cnYui/switch-robot-diy/demo/animation_contact_sheet.jpg

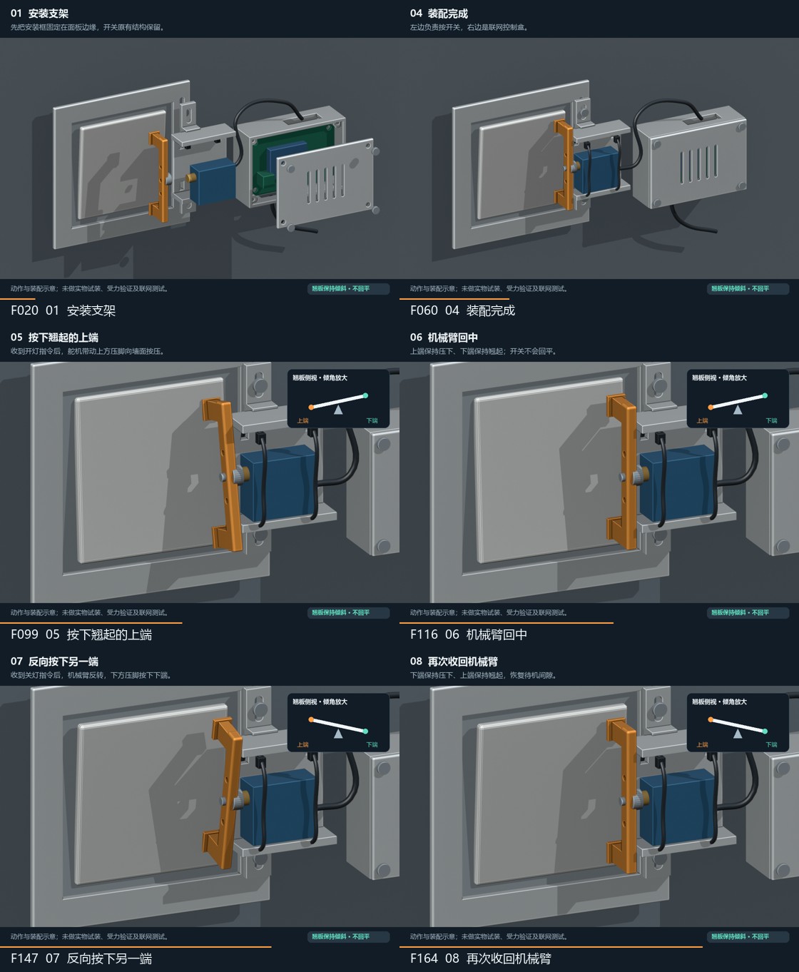
demo/animation_contact_sheet.jpg
