cnYui/switch-robot-diy/electronics/v04/carrier_v04_pcb.png

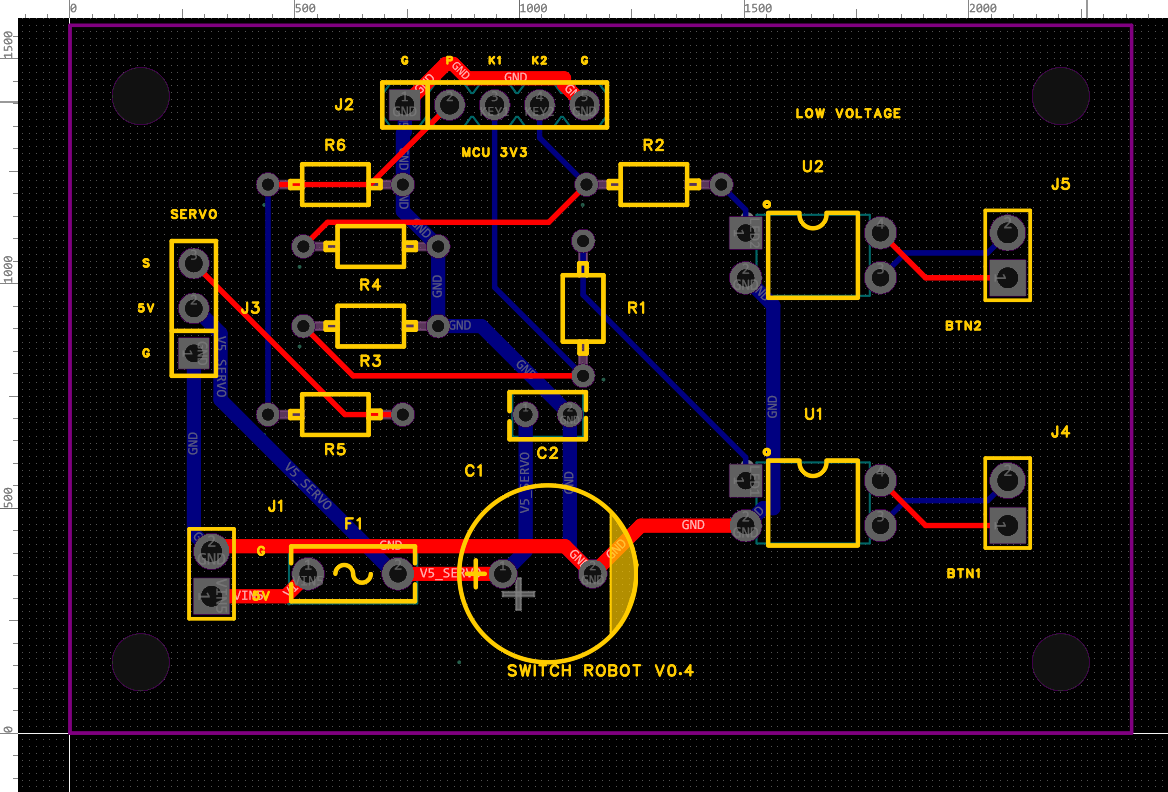
electronics/v04/carrier_v04_pcb.png
