cnYui/switch-robot-diy/fit-check/case_v03_pcb_fit.png

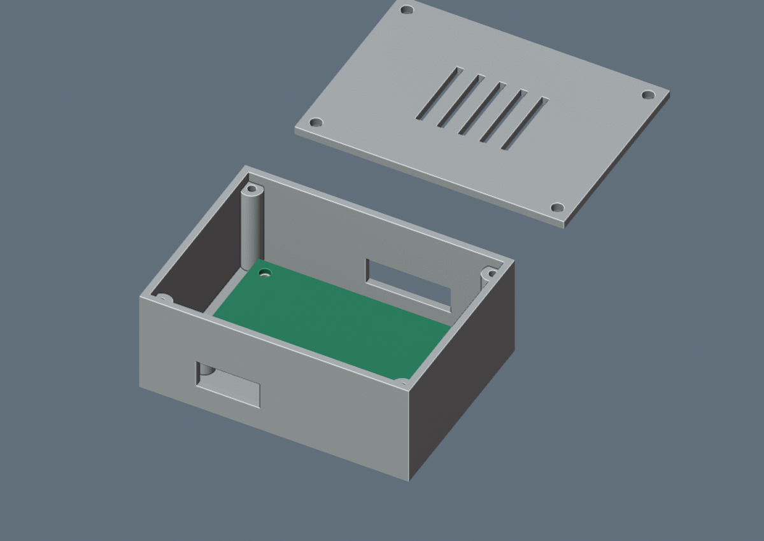
fit-check/case_v03_pcb_fit.png
