cnYui/switch-robot-diy/fit-check/pcb_case_fit_audit.png

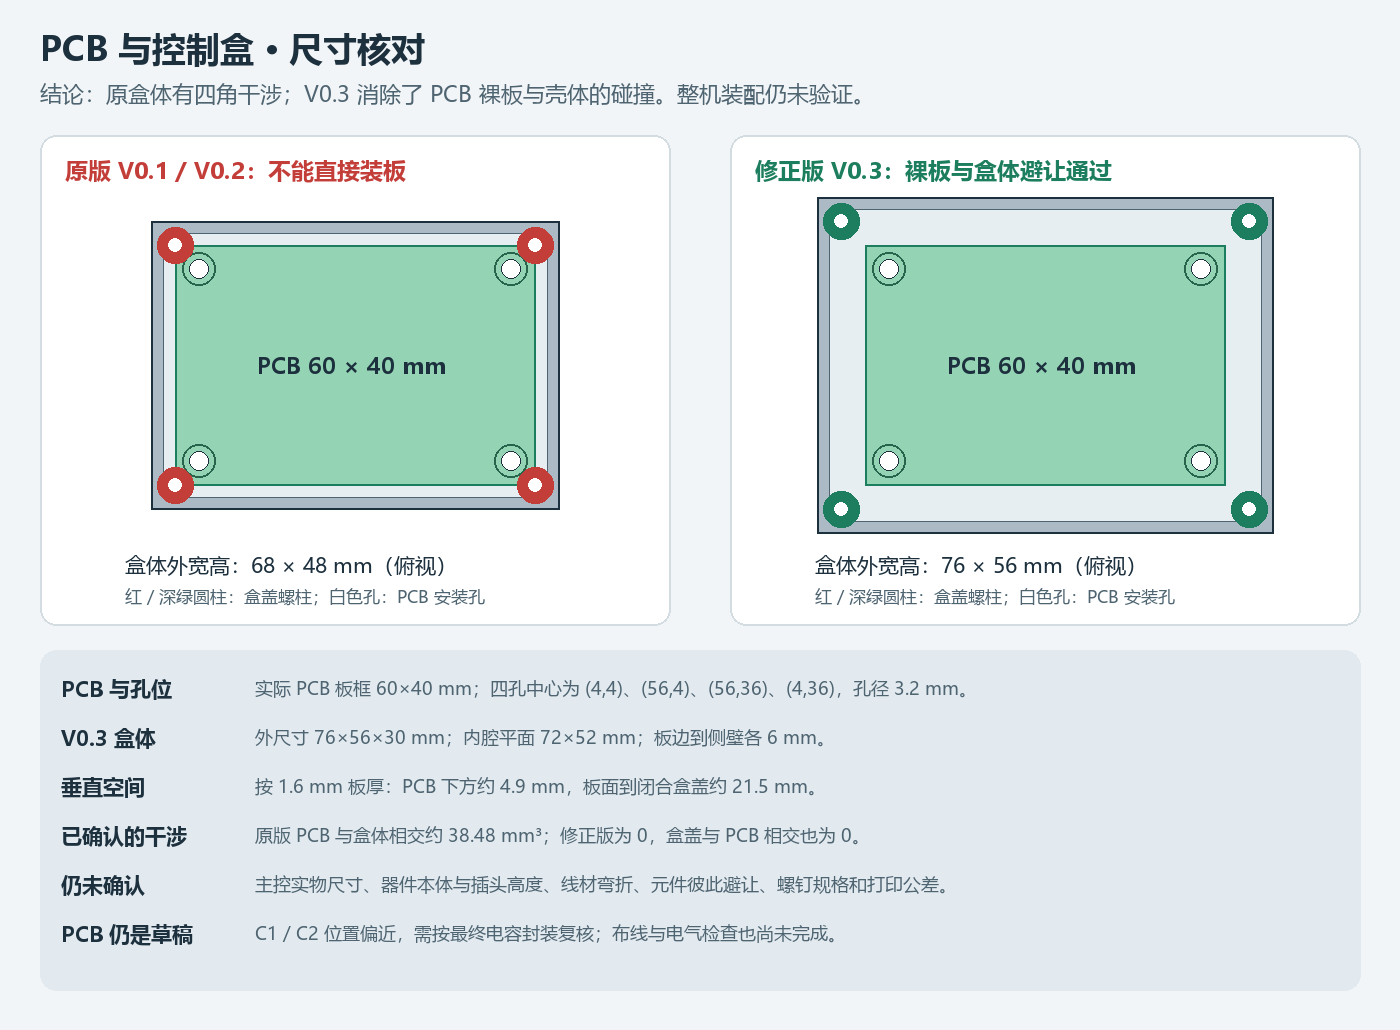
fit-check/pcb_case_fit_audit.png
