cnYui/switch-robot-diy/mechanical/HARDWARE_BOM.md

# 五金与小件采购清单（V0.7 紧固件，2026-11-12）

## V0.7 紧固件（已在 CAD 里建实体并做干涉检查）

每颗螺丝和垫圈都在 switch_robot_86_v07_fasteners.blend 里有实体（名字以 FASTENER_ 开头，自定义属性里写了规格和淘宝规格名）。M3 盘头：头径 5.3、头厚 1.9、螺纹 3.0 mm，取自卖家规格图；M2 头部尺寸是假设值。build_fasteners.py 建模，verify_fasteners.py 用取点法算干涉和咬合，结果在 fastener_checks_v07.json。

| 编号 | 位置 | 规格 | 用量 | 拧进深度（计算） | 尖端后余量 | 干涉 |
|---|---|---|---|---|---|---|
| F1 | PCB → 盒底螺柱 | 盘头十字自攻 M3×6（PA3×6）304 | 4 | 3.5 mm（螺柱 Ø2.3 预钻孔） | 1.5 mm | 无 |
| F2 | 盒盖 → 盖柱 | M3×12 | 4 | 5.7 mm | 孔还剩约 20 mm | 无 |
| F3 | 舵机支架脚 → 框 | M3×6 | 2 | **1.5 mm，偏弱** | 1.05 mm 到 86 面板 | 无 |
| W1 | 支架脚下垫高 | 平垫圈 3.2×7×0.5 | 2（每脚 1 片） | — | — | 无 |
| F4 | 按压臂 → SG90 舵盘 | M2×6 | 2 | 舵盘没建模，未算 | — | 无 |
| — | 舵盘中心螺丝 | SG90 随附 | 1 | — | — | — |

相对 V0.6 改了两处：

1. 网关盒换成 V0.3（76×56×30）。旧的 68×48×22 盒四根盖柱落在 PCB 四个角，装不下（fit-check 早就查出，但 mechanical 里一直是旧盒）。旧 STL 移到 archive，文件名里写了 DOES_NOT_FIT。
2. 垫高 1.0 mm 改为：框下贴 0.5 mm 亚克力泡棉双面胶 + 每个支架脚下 1 片 0.5 mm 垫圈。舵机和按压臂相对翘板的高度与仿真一致。

F3 只咬进框 1.5 mm：框只有 3 mm 厚，换 M3×8 尖端会顶到 86 面板。支架受力只有几牛，先这样装；拧完晃一下，松就在孔里点一滴 502 再拧。

淘宝规格（商品页上看到的规格名和价格，未含运费）：

| 件 | 店 | 规格名 | 价格 |
|---|---|---|---|
| F1 / F3 | [佰瑞特官方旗舰店](https://detail.tmall.com/item.htm?id=15858629599) | M3\*6（200粒)304 | ¥4.86 |
| F2 | 同上 | M3\*12（200粒)304 | ¥6.64 |
| F4 | 同上 | M2\*6（200粒)304 | ¥3.56 |
| W1 | [天卓五金官方旗舰店](https://detail.tmall.com/item.htm?id=849674040028) | 3\*7\*0.5(500只) | ¥14.04 |

合计 ¥29.10。

## V0.6 原始推导（留作对照，螺丝以上面 V0.7 为准）

## 螺丝与垫片

| 位置 | CAD 依据 | 规格 | 用量 | 建议买 |
|---|---|---|---|---|
| PCB → 盒底螺柱（4 处） | PCB 孔 Ø3.2；螺柱预钻孔 Ø2.3、深约 5.9 mm；PCB 厚 1.6 mm | M3×6 圆头（盘头）十字 自攻螺丝（PA 型，尖头） | 4 | 20 |
| 盒盖 → 盒盖螺柱（4 处） | 盒盖孔 Ø3.3、盖厚 2.4 mm；螺柱顶面比盒口低 3 mm；预钻孔 Ø2.3 | M3×12 圆头十字 自攻螺丝（PA 型） | 4 | 20 |
| 支架 → 框（2 处） | 框改为 Ø2.5 预钻孔（见下）；叠层：支架脚 3 mm + 垫圈 1.0 mm + 框 3 mm | M3×6 圆头十字 自攻螺丝（PA 型），拧进框里约 2 mm | 2 | 20（与上面同规格，合并买） |
| 支架脚下垫高（名义 1.0 mm） | 每个脚两片 0.5 mm | M3 平垫圈，厚 0.5 mm（DIN125，内径 3.2、外径 7）；不锈钢 | 4 | 20；另买一包 M3 超薄垫片（0.1 / 0.2 / 0.3 / 0.5 / 1.0 mm）用来微调高度 |
| 舵盘 → 按压臂 | 臂上孔：中心 Ø2.5，两侧 Ø2.2，间距 ±9 mm，臂厚 4 mm | 用 SG90 随附的中心螺丝和 2 颗小自攻螺丝；备用 M2×6 圆头自攻螺丝 | 3 | 买舵机时确认带配件包；备用 M2×6 买 10 |
| 舵机固定 | 支架上的绑带孔 3.2×6 mm（共 4 个，两道绑带） | 尼龙扎带 2.5 mm 宽 × 100 mm 长（3 mm 宽的穿不过） | 2 | 100 |

买自攻螺丝时认 “PA 型 / 自攻螺丝 / 圆头（盘头）/ 十字”，不要买机牙螺丝（M3 机牙需要攻丝）。材质 304 不锈钢或镀黑锌碳钢都行，塑料里拧自攻钉，碳钢更利。

## 其他要买的小件

| 件 | 规格 | 数量 | 说明 |
|---|---|---|---|
| 舵机 | SG90 9g，塑料齿，带配件包 | 1 + 1 备 | 设计参数按 SG90 假设；翻转阻力实测超过 4 N 就要换更大力矩的舵机 |
| 弹性压垫 | 5 mm 厚、带背胶的闭孔泡棉或硅胶海绵，裁成 4×7 mm | 2（裁片需要整张） | 仿真假设压缩刚度 2 N/mm，实测 1.5 ~ 2.5 才合适；建议买软硬两种各一小张，装机后比较 |
| 双面胶（框 → 86 面板） | 亚克力泡棉双面胶，0.5 mm 厚优先 | 1 卷 | 胶的厚度会抬高整个支架，等于垫圈的一部分：垫圈 + 胶 总共约 1.0 mm，别叠加 |
| 杜邦线 | 2.54 mm 母对母 20 cm | 1 包 | PCB 的 J1 ~ J5 都是 2.54 mm 排针 |
| 螺丝刀 | PH0 + PH1 十字 | 1 套 | PH0 拧 M2，PH1 拧 M3 |

## 这次为了能装上，改了一处 CAD

框（PRINT_01）原来在 (42, ±29) 有 3.4 mm 的通槽，钉头或螺母会落在下面的 86 面板上（面板边缘在 x = 43，槽在 x = 40.3 ~ 43.7），装不上。改成实心 + Ø2.5 mm 预钻孔，自攻螺丝从支架脚上方直接拧进框里。支架脚上的 3.4 mm 长孔保留，仍可沿 y 方向调 ±3 mm。新 STL 为 mechanical/PRINT_01_86_adjustable_frame.stl，旧的在 mechanical/archive。仿真没有重跑：框的碰撞体不含槽，碰撞模型不受影响。

## 未核实（收货后先量）

1. 螺柱预钻孔 Ø2.3 对 M3 自攻螺丝偏紧，先打一个样；拧不进或柱子开裂，就用 2.5 mm 钻头手扩。
2. 螺柱孔深、PCB 实际厚度：PCB 按 1.6 mm 假设。
3. 舵盘的孔位和厚度：臂上的孔距 ±9 mm 是按 SG90 双臂舵盘假设的，拿到实物先对。
4. 支架脚与框之间叠层超过 1.5 mm 时（垫圈 + 胶），M3×6 在框里不到 1.5 mm，咬合偏少；此时改用 M3×8 并让钉尖落在框的外沿，或把垫高改回用更薄的胶。
5. 压垫刚度；SG90 的力矩与翻转阻力。

## 淘宝商品（2026-11-12 搜索结果）

通过本机的 cn-scraper-mcp 搜索得到。价格是列表上的默认规格价，实际价格以你在页面里选的规格为准；销量是列表显示的“N 人付款”。规格选项（长度、数量、材质）要进商品页自己选，我没法替你确认，下面写了该选什么。没有加购物车，也没有下单。

| 件 | 选的商品 | 列表价 | 销量 | 进页面后选什么 / 注意 |
|---|---|---|---|---|
| M3×6 和 M3×12 自攻螺丝（同一个商品） | [304 不锈钢圆头自攻螺丝 佰瑞特](https://item.taobao.com/item.htm?id=15858629599) | M3×6 200 粒 ¥2.13；M3×12 200 粒 ¥3.64 | 3 万+ | 两个长度各拍一份。备选：[M3×6 100 只](https://item.taobao.com/item.htm?id=556999745246) ¥2.65，[M3×12 100 只](https://item.taobao.com/item.htm?id=15639979370) ¥3.66 |
| M3 垫圈 0.5 mm（垫高用） | [天卓五金 304 平垫片 3×5×0.5 500 只](https://item.taobao.com/item.htm?id=849674040028) | ¥7.71 | 2000+ | 外径 5 mm，收到后确认 M3 螺丝能穿过；穿不过就改买 [M3×6×0.5 的 2000 个装](https://item.taobao.com/item.htm?id=721571255302) ¥16.70（全网 70 万+） |
| 微调用 0.2 mm 垫圈 | [304 平垫圈 M3×5×0.2 200 粒](https://item.taobao.com/item.htm?id=941703196459) | ¥2.22 | 1 万+ | 与 0.5 mm 配合可以做 0.2 / 0.5 / 0.7 / 1.0 的组合 |
| M2×6 自攻螺丝（舵盘备用） | [9g 舵机自攻螺丝 M2×6 100 颗](https://item.taobao.com/item.htm?id=543737994601)（牛牌航空工厂店） | ¥4.49 | 100+ | 选 M2×6 |
| 扎带 2.5 mm 宽 × 100 mm | [自锁式尼龙扎带 PA66 100 条](https://item.taobao.com/item.htm?id=765121326094) | ¥2.12 | 4 万+ | 选宽 2.5 mm、长 100 mm 的规格。备选：[2.5×100 mm 100 根](https://item.taobao.com/item.htm?id=976187157563) ¥3.22 |
| SG90 舵机 | [SG90 9G 舵机 带配件](https://item.taobao.com/item.htm?id=678498890304) | ¥5.67 | 3 万+ | 买 2 个。列表里有“5 孔 / 6 孔”等舵盘版本，对照臂上的孔距 ±9 mm 选，拿不准就问客服要双臂舵盘的孔距；备用舵盘包：[5 孔配件包](https://item.taobao.com/item.htm?id=744224321565) ¥0.99 |
| 更大力矩的备选舵机 | [SG90 / MG90S](https://item.taobao.com/item.htm?id=580422934211)（新动模型） | ¥5.15 | 1000+ | 选 MG90S（金属齿），买 1 个备用；实测开关阻力超过 4 N 才用得上 |
| 压垫 A：泡棉 | [3M 海绵胶带 5 mm 厚 1 cm×2 m](https://item.taobao.com/item.htm?id=656224946508) | ¥6.87 | 1 万+ | 裁成 4×7 mm |
| 压垫 B：硅胶发泡 | [祥晨自粘硅胶发泡板 200×300×5 mm](https://item.taobao.com/item.htm?id=660657977751) | ¥7.90 | 10 万+ | 如果有软硬度选项，各选一种；与泡棉对比装机后的手感和仿真假设的 2 N/mm |
| 框与面板的双面胶 | [亚克力泡棉双面胶 0.5 mm 厚 10 mm 宽 × 33 m](https://item.taobao.com/item.htm?id=941026615259)（加腾胶带） | ¥12.54 | 26 | 销量很少。备选：[1 mm 厚 5 mm 宽 30 m 的亚克力双面胶](https://item.taobao.com/item.htm?id=878944546787) ¥3.36（1 万+），用 1 mm 的胶就不用再垫垫圈 |
| 杜邦线 | [全铜杜邦线 母对母 20 cm 40P](https://item.taobao.com/item.htm?id=843896292070) | ¥7.60 | 1000+ | |
| 十字螺丝刀 | [得力精密螺丝刀套装 57 件](https://item.taobao.com/item.htm?id=726463206932) | ¥56.90 | 900+ | 确认套装里有 PH0 和 PH1；只想花 10 多块可以看 [S2 磁性 12 件套](https://item.taobao.com/item.htm?id=608364940838) ¥12.70，同样要确认有 PH0 / PH1 |

这份清单没验证：各规格是否有货、长度和数量的实际 SKU、泡棉和硅胶的软硬度、舵盘孔距。商品详情接口不稳定，12 个里只拿到 3 个，所以没有逐项核对页面。
