cnYui/switch-robot-diy/electronics/v04/carrier_v04_bom.csv

No. | Quantity | Comment | Designator | Footprint | Value | Manufacturer Part | Manufacturer | Supplier Part | Supplier
1 | 1 | 470uF | C1 | CAP-TH_BD10.0-P5.00-D1.0-FD | 470uF | EEUFR1E471 | PANASONIC(松下) | C407944 | LCSC
2 | 1 | 100nF | C2 | CAP-TH_L4.0-W2.5-P2.50-D0.5 | 100nF | FK18X7R1H104K | TDK | C3689569 | LCSC
3 | 1 | RUEF110 | F1 | FUSE-TH_L7.0-W3.1-P5.08-D1.2 |  | RUEF110 | Littelfuse(美国力特) | C5395 | LCSC
4 | 3 | PZ254V-11-02P | J1,J4,J5 | HDR-TH_2P-P2.54-V-M |  | PZ254V-11-02P | XFCN(兴飞) | C492401 | LCSC
5 | 1 | PZ254V-11-05P | J2 | HDR-TH_5P-P2.54-V-M |  | PZ254V-11-05P | XFCN(兴飞) | C492404 | LCSC
6 | 1 | PZ254V-11-03P | J3 | HDR-TH_3P-P2.54-V-M_PZ254V-11-03P |  | PZ254V-11-03P | XFCN(兴飞) | C2937625 | LCSC
7 | 2 | 470Ω | R1,R2 | RES-TH_BD2.3-L3.7-P7.70-D0.9 | 470Ω | MF1/8W-470Ω±1%-OT52 | VO(翔胜) | C2848568 | LCSC
8 | 3 | 100kΩ | R3,R4,R6 | RES-TH_BD2.3-L3.7-P7.70-D0.9 | 100kΩ | MF1/8W-100K±1%-OT26 | VO(翔胜) | C2903382 | LCSC
9 | 1 | 220Ω | R5 | RES-TH_BD2.3-L3.7-P7.70-D0.9 | 220Ω | MF1/8W-220Ω±1%-OT52 | VO(翔胜) | C2848564 | LCSC
10 | 2 | AQY212EH | U1,U2 | DIP-4_L6.4-W4.8-P2.54-LS7.6-BL |  | AQY212EH | PANASONIC(松下) | C2894775 | LCSC
