cnYui/switch-robot-diy/electronics/v04/3d/carrier_v04_populated.obj

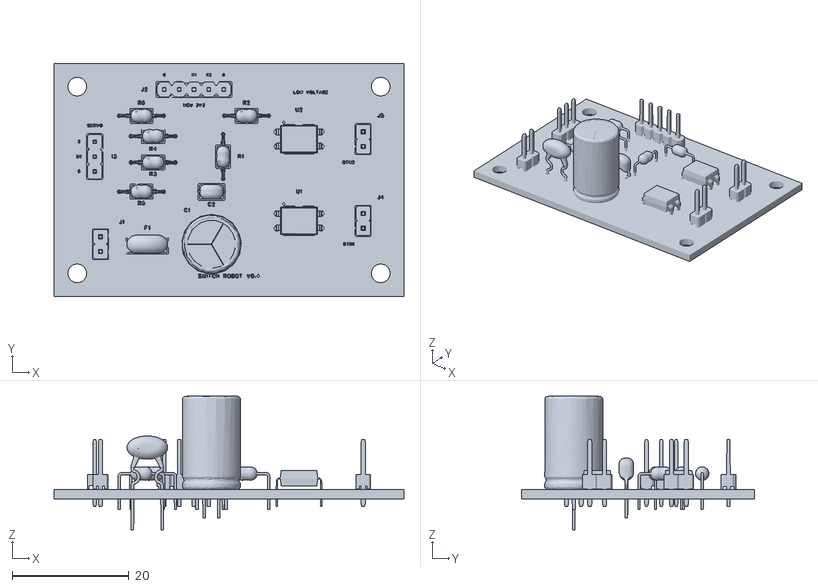
[picture p5: CAD file, 2026-11-12]
electronics/v04/3d/carrier_v04_populated.obj
60.0 x 40.0 x 22.9
