cnYui/switch-robot-diy/fit-check/V03_PRINT_gateway_lid_76x56.stl

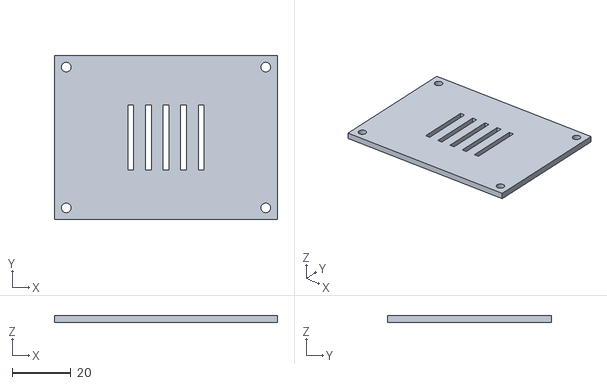
[picture p6: CAD file, 2026-11-12]
fit-check/V03_PRINT_gateway_lid_76x56.stl
76.0 x 56.0 x 2.40
