cnYui/switch-robot-diy/mechanical/PRINT_02_strap_servo_cradle.stl

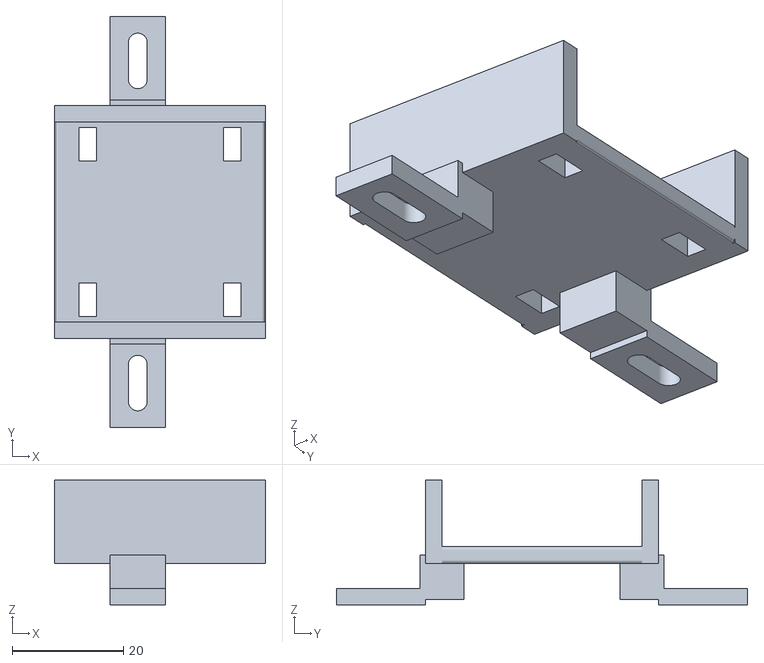
[picture p7: CAD file, 2026-11-12]
mechanical/PRINT_02_strap_servo_cradle.stl
38.0 x 74.0 x 22.5
