cnYui/switch-robot-diy/simulation/assets/pcb_material_00.obj

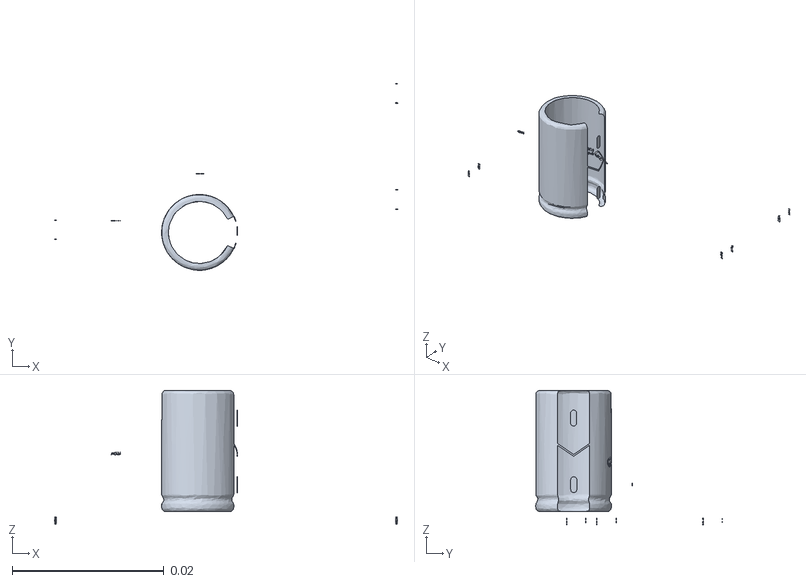
[picture p8: CAD file, 2026-11-12]
simulation/assets/pcb_material_00.obj
0.0453 x 0.0246 x 0.0177
