cnYui/switch-robot-diy/simulation/V05_CANDIDATE_press_arm.stl

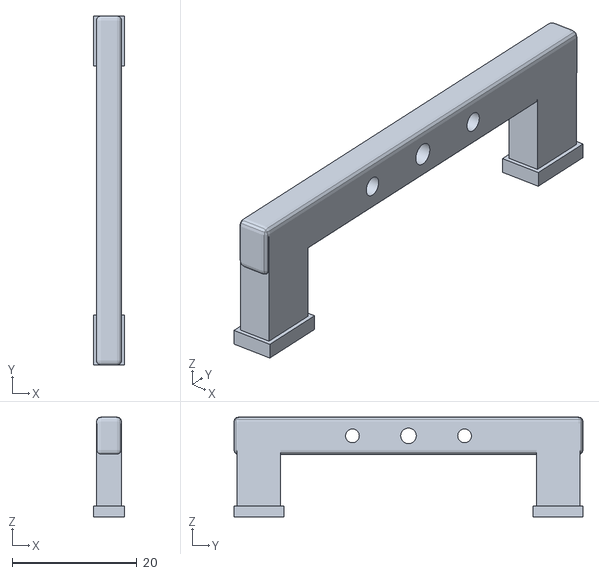
[picture p9: CAD file, 2026-11-12]
simulation/V05_CANDIDATE_press_arm.stl
5.00 x 56.0 x 16.0
