cnYui/switch-robot-diy/fit-check/V03_PRINT_gateway_case_76x56x30.stl

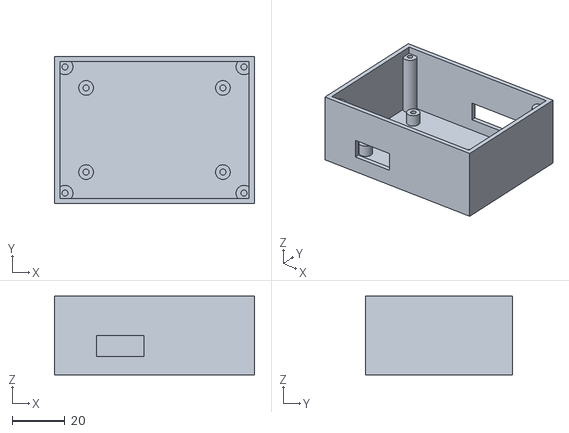
[picture p10: CAD file, 2026-11-12]
fit-check/V03_PRINT_gateway_case_76x56x30.stl
76.0 x 56.0 x 30.0
