cnYui/switch-robot-diy/simulation/assets/pcb_material_03.obj

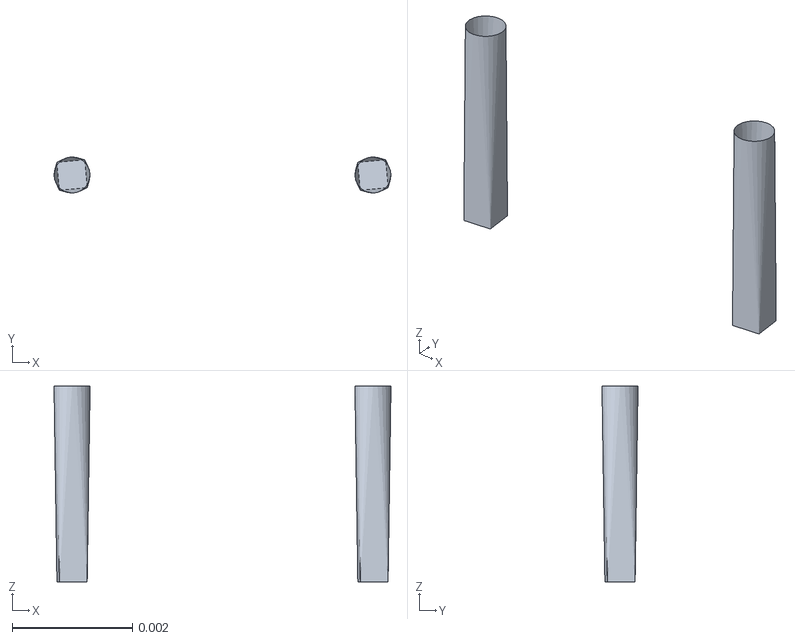
[picture p11: CAD file, 2026-11-12]
simulation/assets/pcb_material_03.obj
0.0056 x 0.0006 x 0.00325
