cnYui/switch-robot-diy/simulation/V06_press_arm.stl

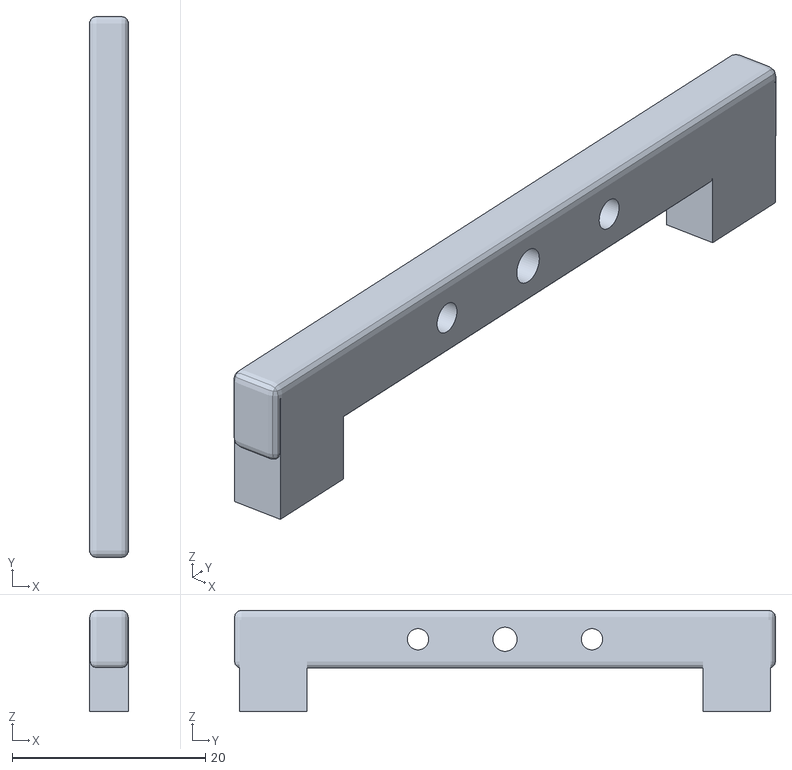
[picture p12: CAD file, 2026-11-12]
simulation/V06_press_arm.stl
4.00 x 56.0 x 10.5
