cnYui/switch-robot-diy/mechanical/PRINT_01_86_adjustable_frame.stl

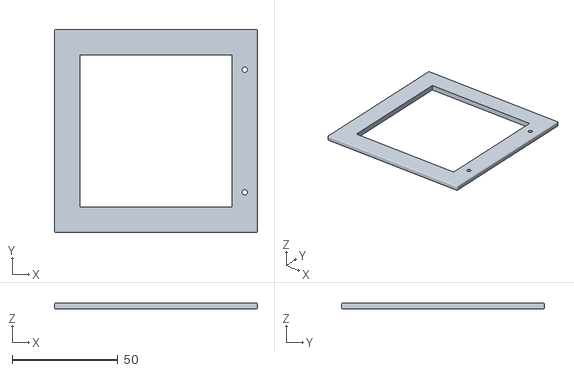
[picture p13: CAD file, 2026-11-12]
mechanical/PRINT_01_86_adjustable_frame.stl
96.0 x 96.0 x 3.00
