cnYui/switch-robot-diy/simulation/assets/frame_col_01.obj

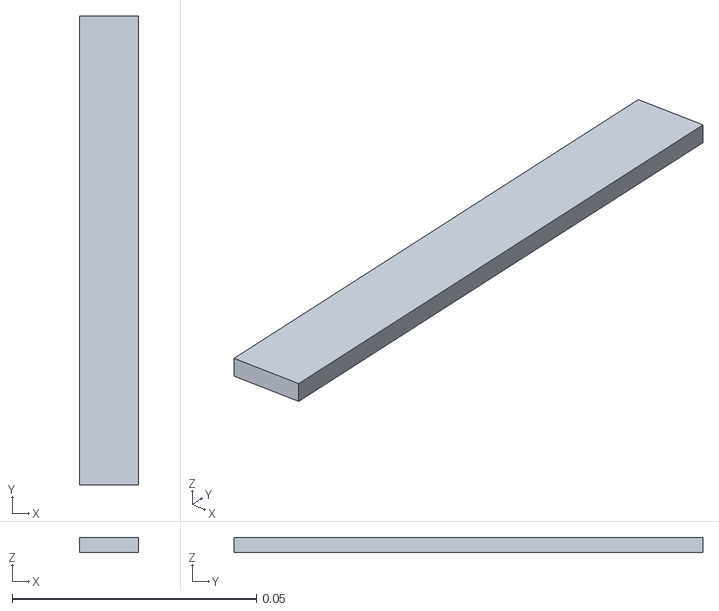
[picture p14: CAD file, 2026-11-12]
simulation/assets/frame_col_01.obj
0.012 x 0.096 x 0.003
