cnYui/switch-robot-diy/simulation/assets/cradle_col_04.obj

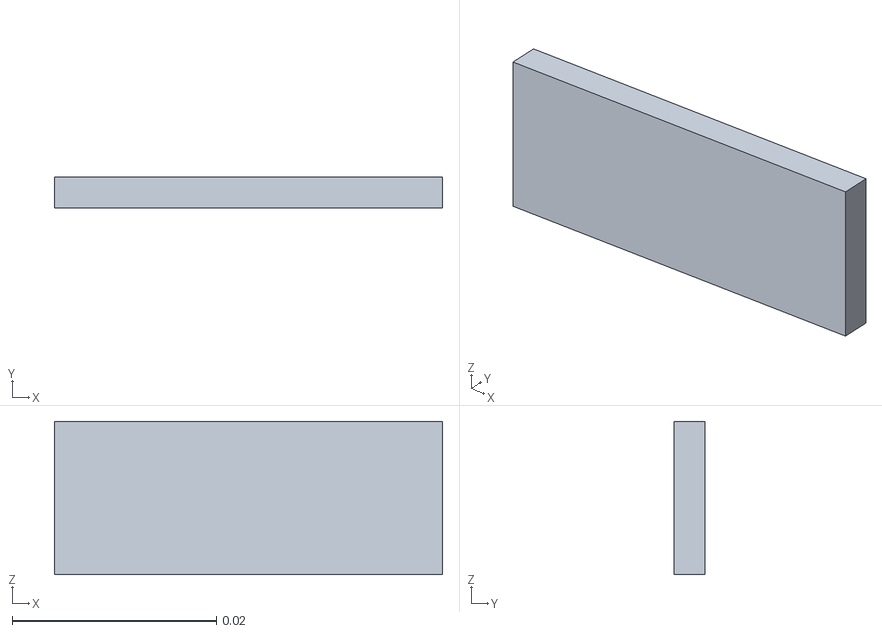
[picture p15: CAD file, 2026-11-12]
simulation/assets/cradle_col_04.obj
0.038 x 0.003 x 0.015
