cnYui/switch-robot-diy/simulation/assets/cradle_col_02.obj

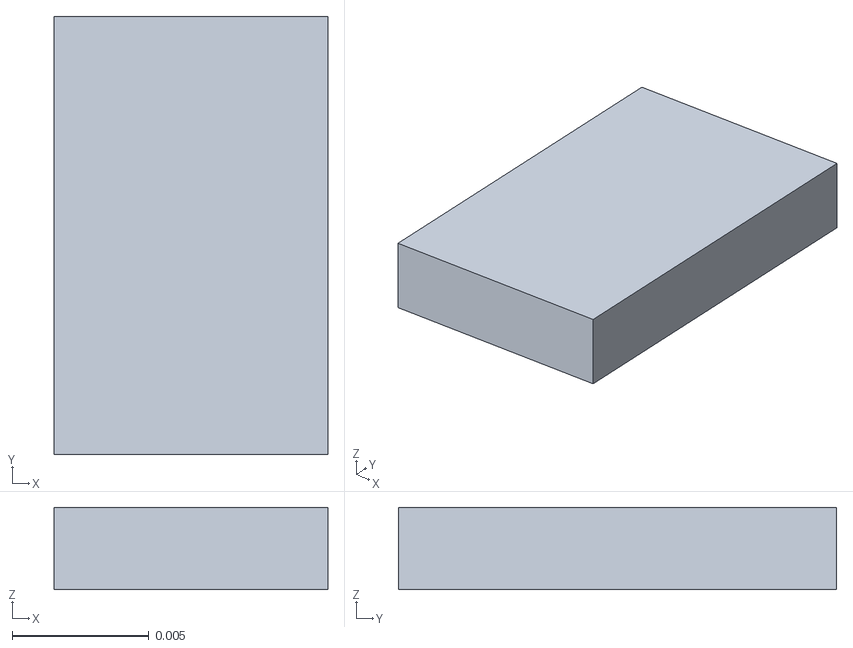
[picture p16: CAD file, 2026-11-12]
simulation/assets/cradle_col_02.obj
0.01 x 0.016 x 0.003
