cnYui/switch-robot-diy/simulation/assets/pcb_material_07.obj

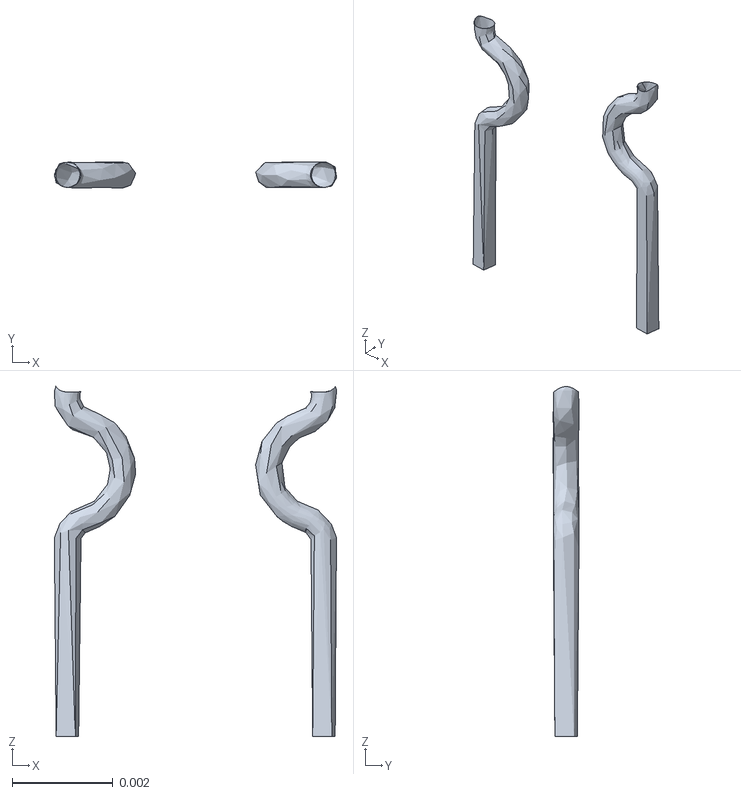
[picture p17: CAD file, 2026-11-12]
simulation/assets/pcb_material_07.obj
0.00561 x 0.000518 x 0.00696
