cnYui/switch-robot-diy/simulation/assets/pcb_material_15.obj

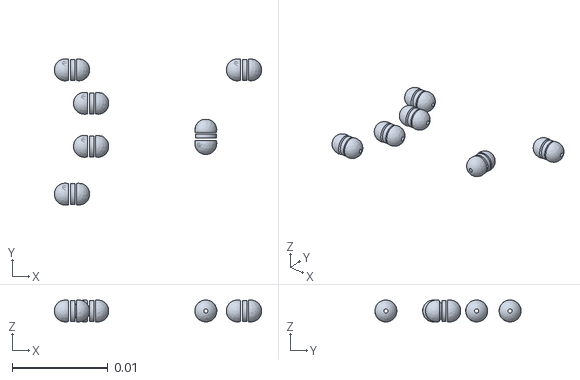
[picture p18: CAD file, 2026-11-12]
simulation/assets/pcb_material_15.obj
0.0217 x 0.0153 x 0.0023
