cnYui/switch-robot-diy/simulation/assets/cradle_col_00.obj

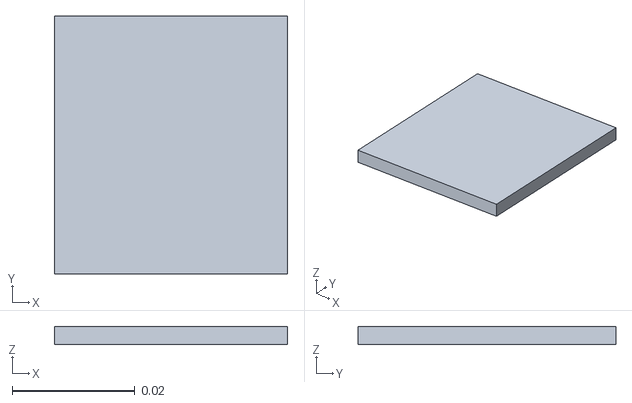
[picture p19: CAD file, 2026-11-12]
simulation/assets/cradle_col_00.obj
0.038 x 0.042 x 0.003
