cnYui/switch-robot-diy/simulation/assets/pcb_material_11.obj

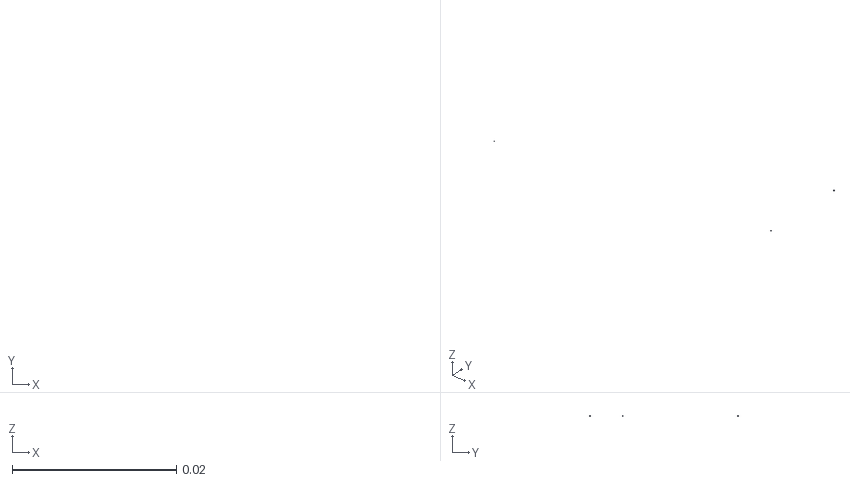
[picture p20: CAD file, 2026-11-12]
simulation/assets/pcb_material_11.obj
0.045 x 0.018 x 3.66e-05
