cnYui/switch-robot-diy/simulation/assets/arm_v06_col_01.obj

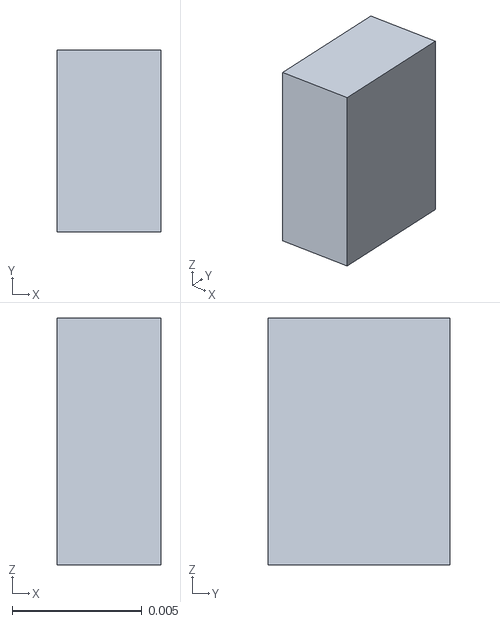
[picture p21: CAD file, 2026-11-12]
simulation/assets/arm_v06_col_01.obj
0.004 x 0.007 x 0.0095
