cnYui/switch-robot-diy/simulation/assets/cradle_col_06.obj

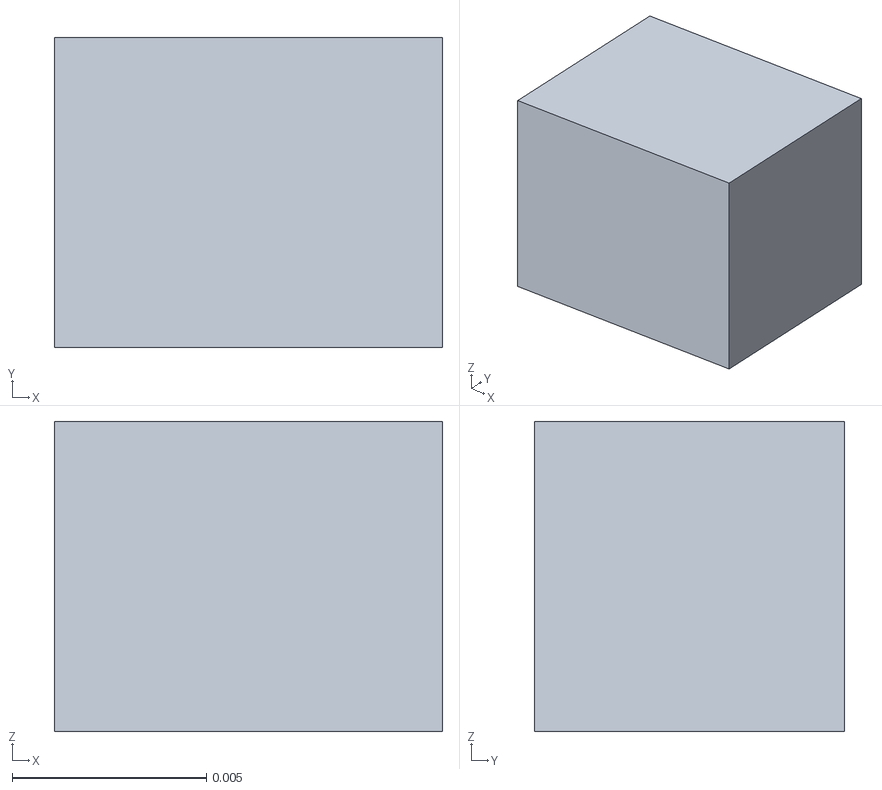
[picture p22: CAD file, 2026-11-12]
simulation/assets/cradle_col_06.obj
0.01 x 0.008 x 0.008
