cnYui/switch-robot-diy/simulation/assets/frame.obj

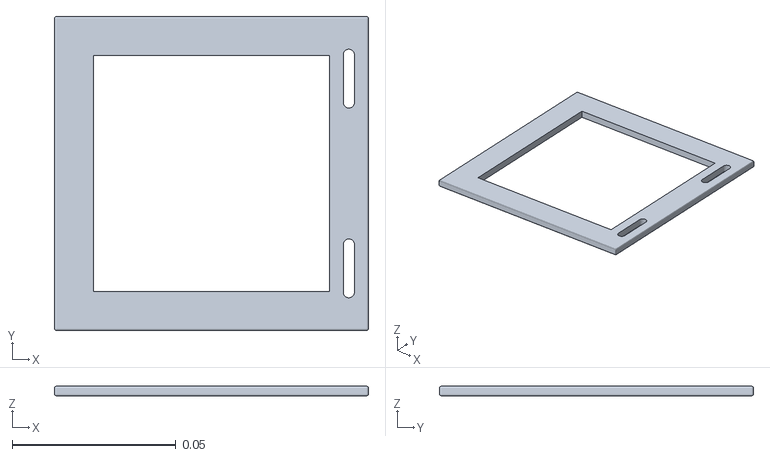
[picture p23: CAD file, 2026-11-12]
simulation/assets/frame.obj
0.096 x 0.096 x 0.003
