cnYui/switch-robot-diy/simulation/assets/pcb_material_18.obj

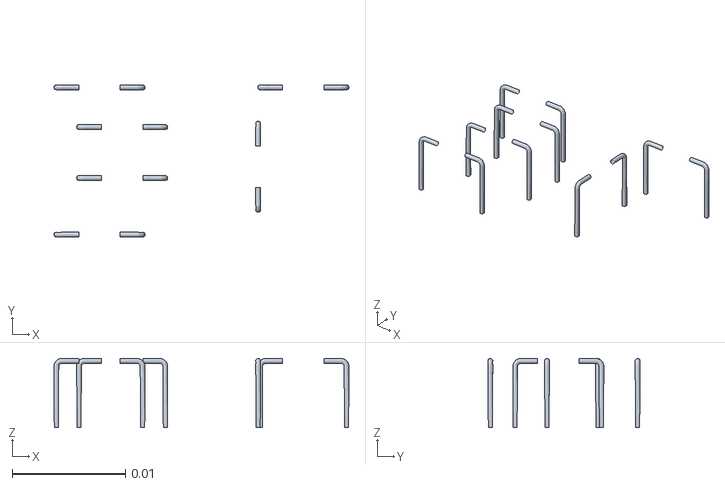
[picture p24: CAD file, 2026-11-12]
simulation/assets/pcb_material_18.obj
0.026 x 0.0134 x 0.0061
