cnYui/switch-robot-diy/simulation/assets/pcb_material_16.obj

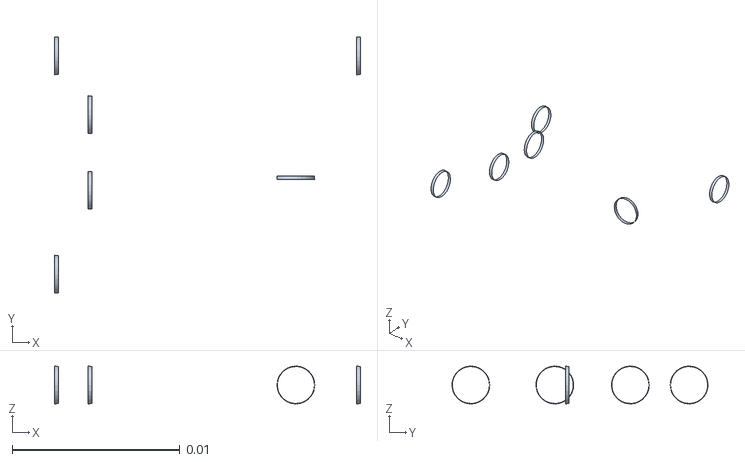
[picture p25: CAD file, 2026-11-12]
simulation/assets/pcb_material_16.obj
0.0182 x 0.0153 x 0.00225
