cnYui/switch-robot-diy/simulation/assets/lid_v03_closed.obj

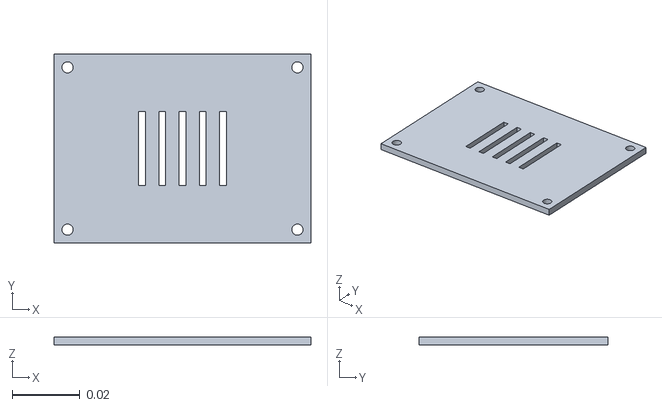
[picture p26: CAD file, 2026-11-12]
simulation/assets/lid_v03_closed.obj
0.076 x 0.056 x 0.0024
