cnYui/switch-robot-diy/simulation/assets/case_v03.obj

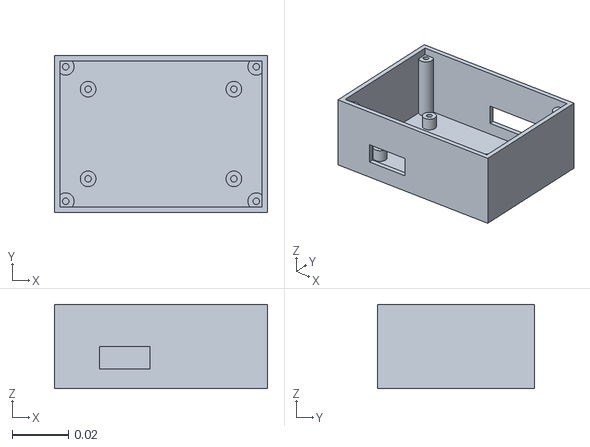
[picture p27: CAD file, 2026-11-12]
simulation/assets/case_v03.obj
0.076 x 0.056 x 0.03
