cnYui/switch-robot-diy/simulation/assets/frame_col_03.obj

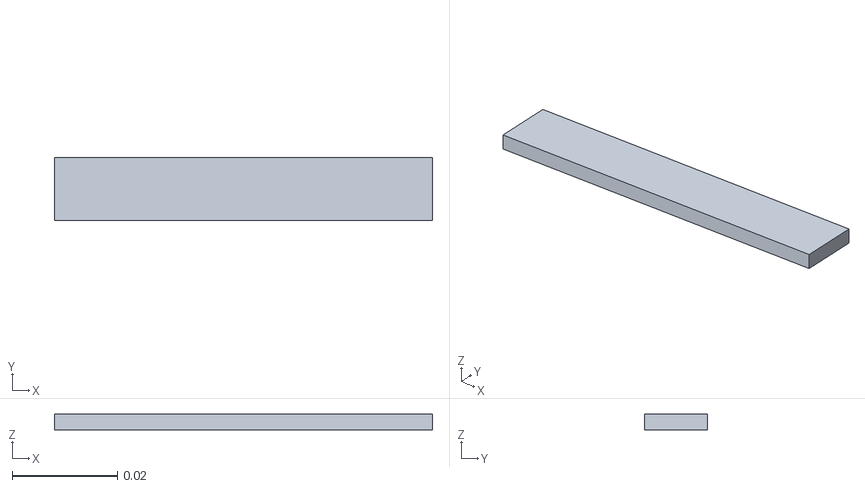
[picture p28: CAD file, 2026-11-12]
simulation/assets/frame_col_03.obj
0.072 x 0.012 x 0.003
