cnYui/switch-robot-diy/simulation/assets/pcb_material_19.obj

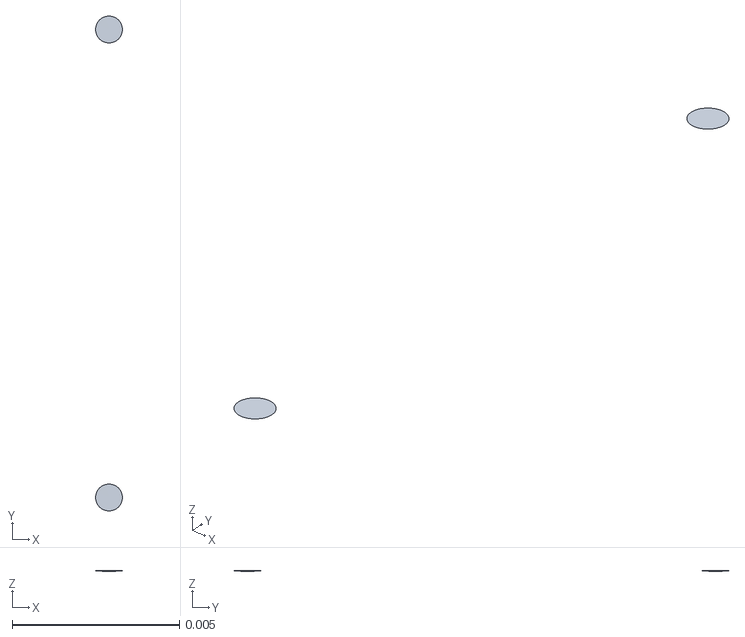
[picture p29: CAD file, 2026-11-12]
simulation/assets/pcb_material_19.obj
0.000807 x 0.0148 x 1e-06
