cnYui/switch-robot-diy/simulation/assets/pcb_material_06.obj

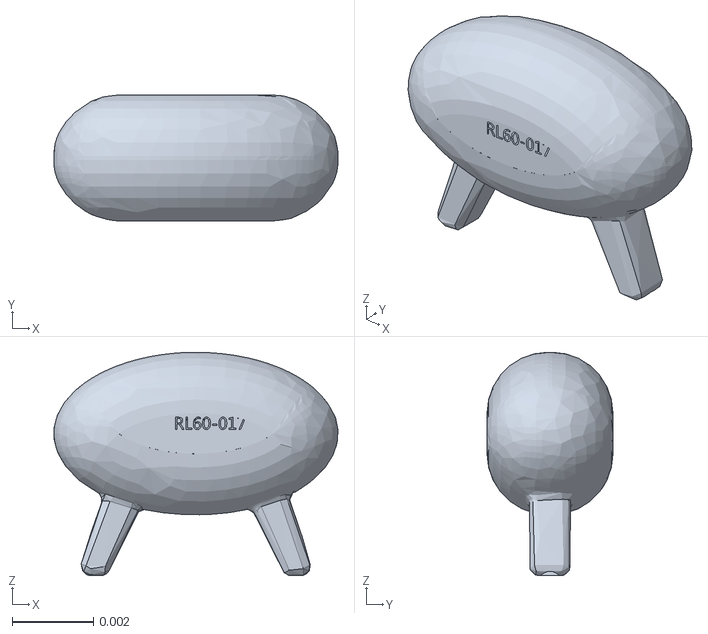
[picture p30: CAD file, 2026-11-12]
simulation/assets/pcb_material_06.obj
0.00699 x 0.0031 x 0.0055
