cnYui/switch-robot-diy/simulation/assets/rocker_original.obj

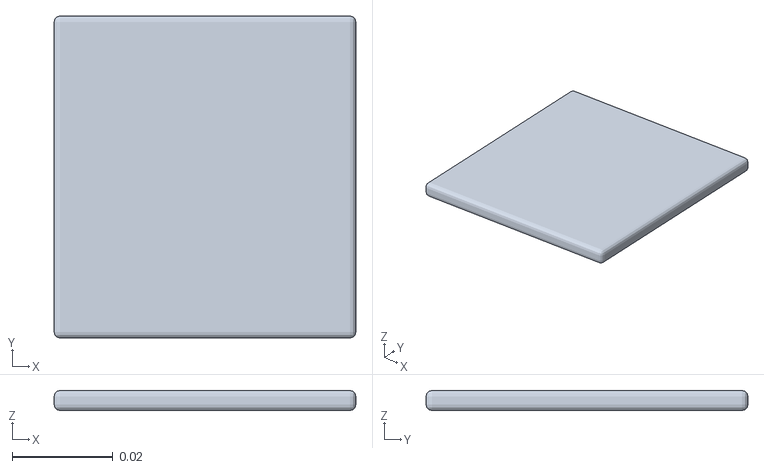
[picture p31: CAD file, 2026-11-12]
simulation/assets/rocker_original.obj
0.06 x 0.064 x 0.004
