cnYui/switch-robot-diy/simulation/assets/pcb_material_12.obj

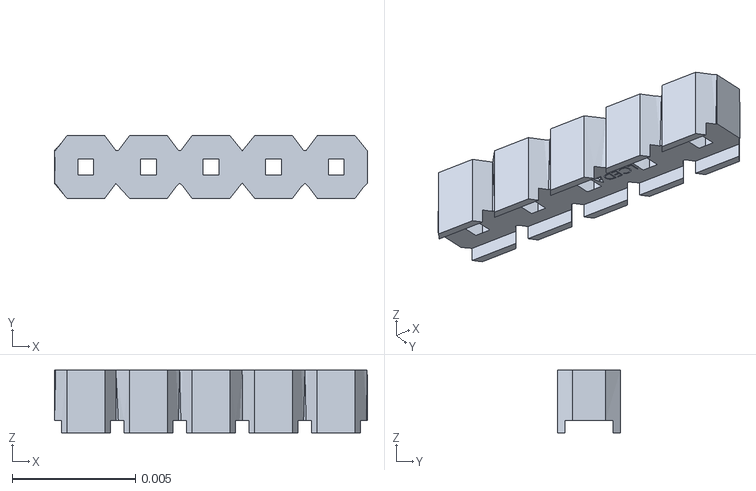
[picture p32: CAD file, 2026-11-12]
simulation/assets/pcb_material_12.obj
0.0127 x 0.00254 x 0.00254
