cnYui/switch-robot-diy/simulation/assets/faceplate.obj

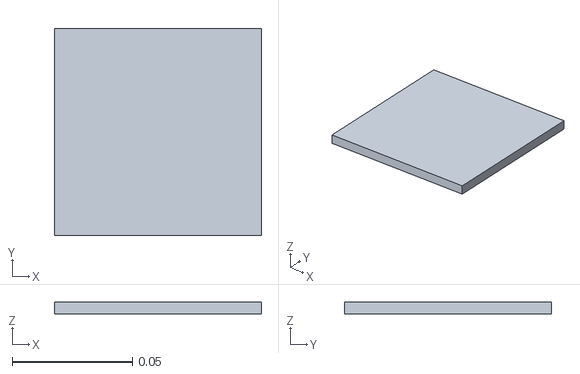
[picture p33: CAD file, 2026-11-12]
simulation/assets/faceplate.obj
0.086 x 0.086 x 0.005
