cnYui/switch-robot-diy/simulation/assets/servo_shaft.obj

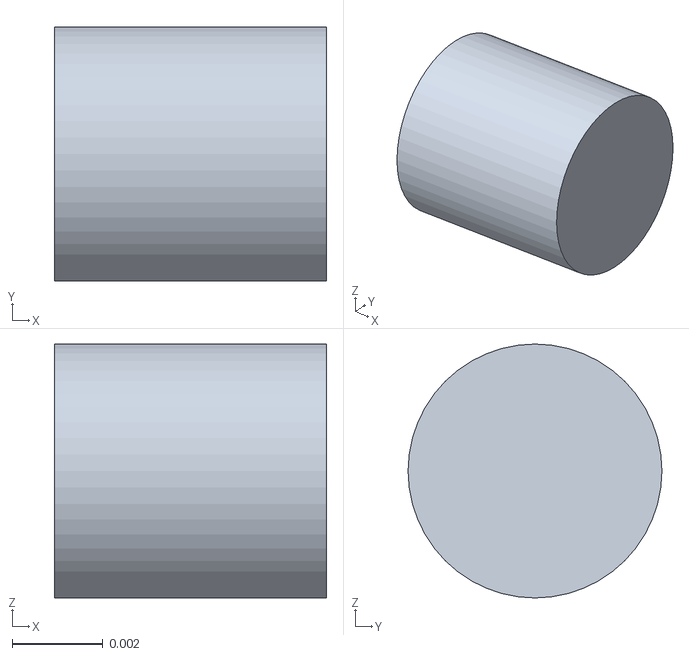
[picture p34: CAD file, 2026-11-12]
simulation/assets/servo_shaft.obj
0.006 x 0.0056 x 0.0056
