cnYui/switch-robot-diy/simulation/assets/arm_v06.obj

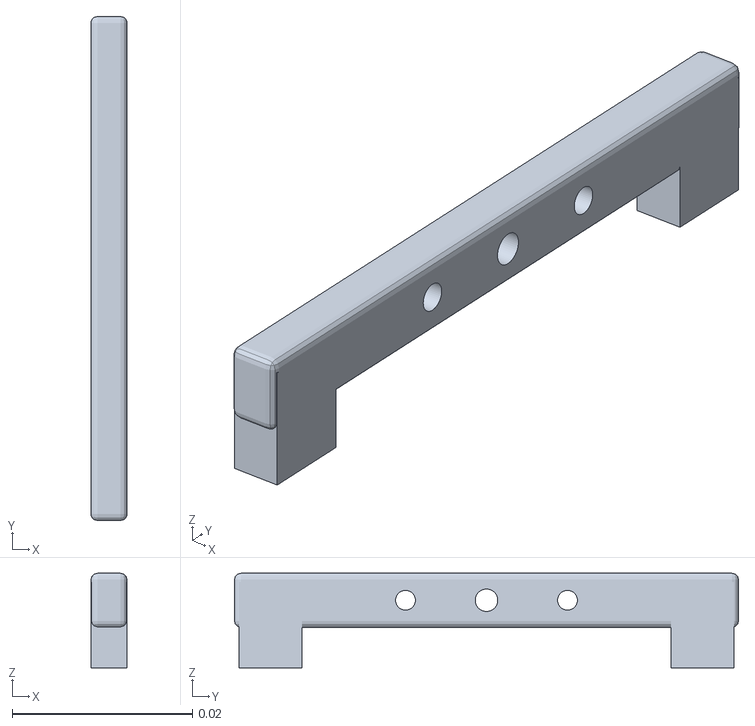
[picture p35: CAD file, 2026-11-12]
simulation/assets/arm_v06.obj
0.004 x 0.056 x 0.0105
