cnYui/switch-robot-diy/simulation/assets/arm_v06_col_04.obj

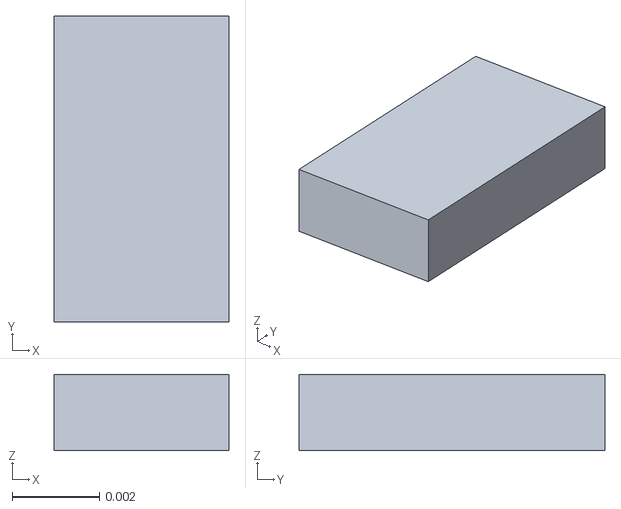
[picture p36: CAD file, 2026-11-12]
simulation/assets/arm_v06_col_04.obj
0.004 x 0.007 x 0.00174
