cnYui/switch-robot-diy/simulation/assets/pcb_material_13.obj

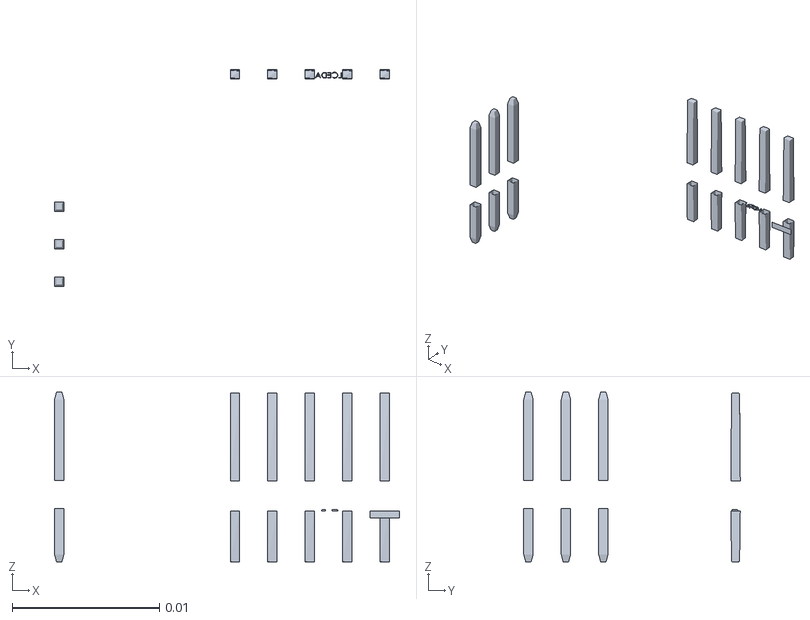
[picture p37: CAD file, 2026-11-12]
simulation/assets/pcb_material_13.obj
0.0234 x 0.0147 x 0.0115
