cnYui/switch-robot-diy/simulation/assets/pcb_material_05.obj

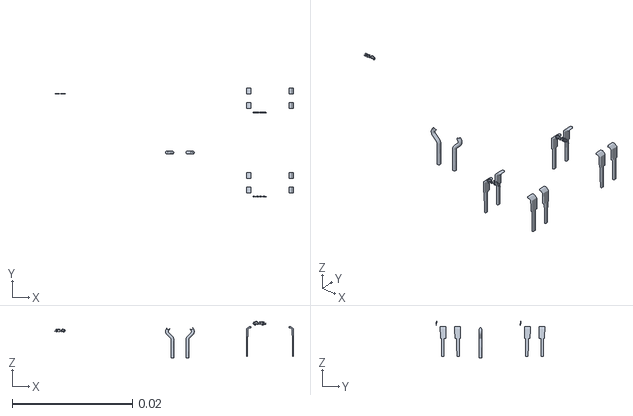
[picture p38: CAD file, 2026-11-12]
simulation/assets/pcb_material_05.obj
0.0398 x 0.0181 x 0.00608
