cnYui/switch-robot-diy/simulation/assets/pcb_material_17.obj

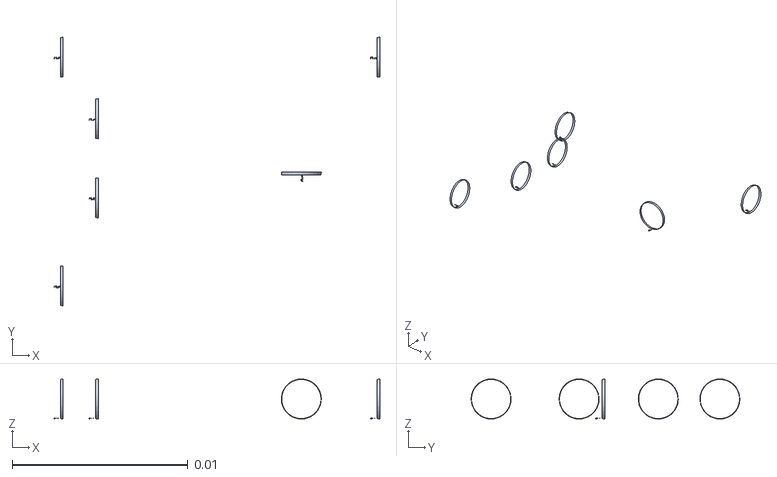
[picture p39: CAD file, 2026-11-12]
simulation/assets/pcb_material_17.obj
0.0185 x 0.0153 x 0.00226
