cnYui/switch-robot-diy/simulation/assets/pcb_material_02.obj

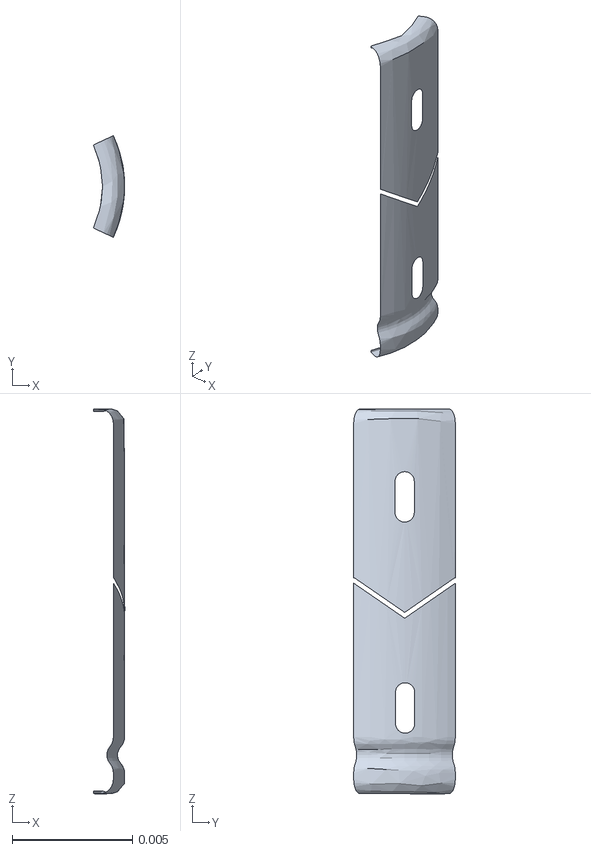
[picture p40: CAD file, 2026-11-12]
simulation/assets/pcb_material_02.obj
0.0013 x 0.00423 x 0.016
