cnYui/switch-robot-diy/simulation/assets/pcb_material_09.obj

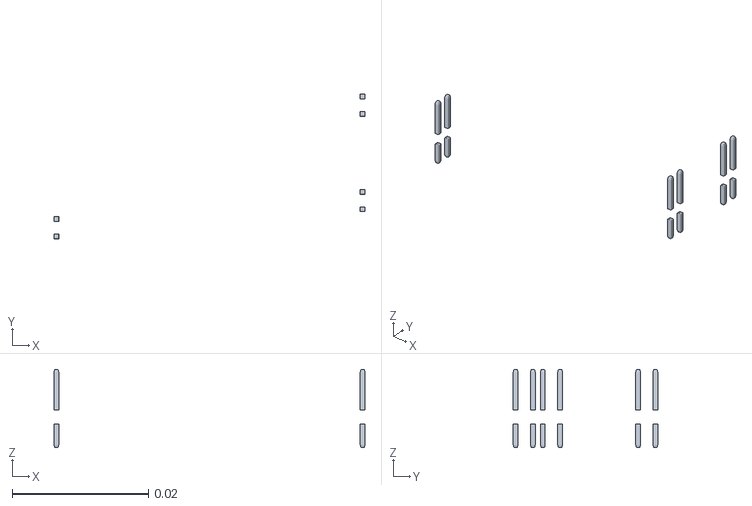
[picture p41: CAD file, 2026-11-12]
simulation/assets/pcb_material_09.obj
0.0457 x 0.0212 x 0.0115
