cnYui/switch-robot-diy/simulation/assets/servo_body.obj

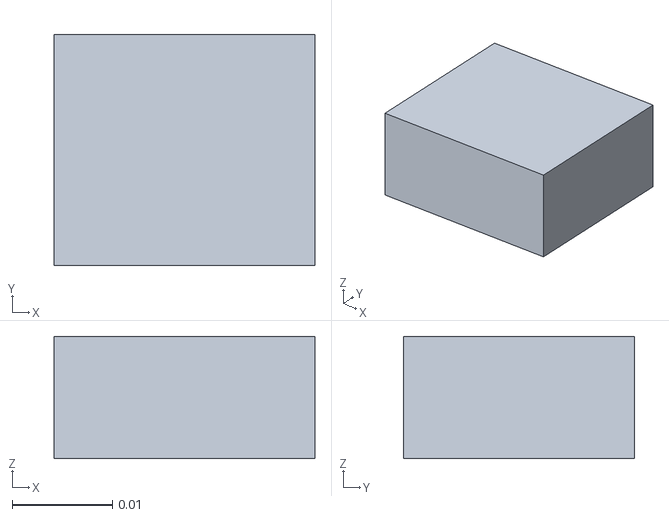
[picture p42: CAD file, 2026-11-12]
simulation/assets/servo_body.obj
0.026 x 0.023 x 0.0122
