cnYui/switch-robot-diy/simulation/assets/pcb_material_20.obj

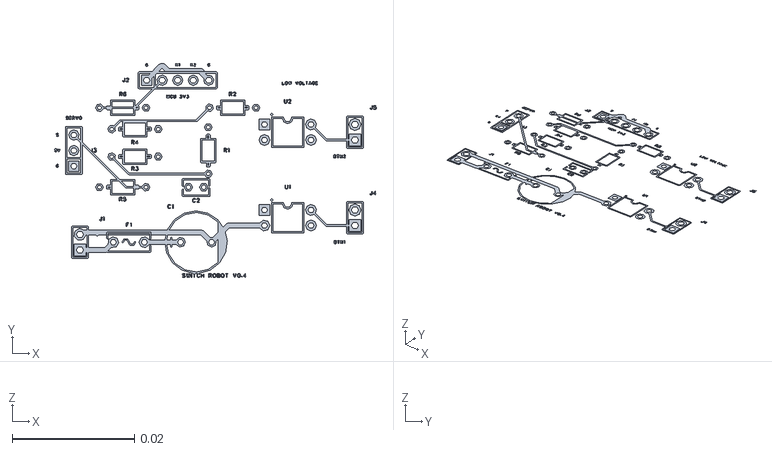
[picture p43: CAD file, 2026-11-12]
simulation/assets/pcb_material_20.obj
0.0527 x 0.0351 x 5e-05
