cnYui/switch-robot-diy/simulation/assets/pcb_material_08.obj

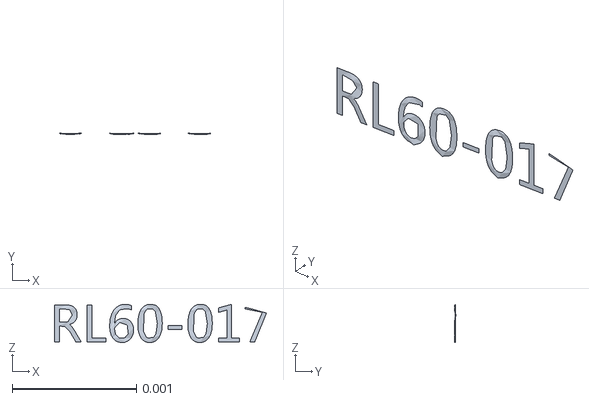
[picture p44: CAD file, 2026-11-12]
simulation/assets/pcb_material_08.obj
0.0017 x 1e-05 x 0.000309
