cnYui/switch-robot-diy/simulation/assets/pcb_material_10.obj

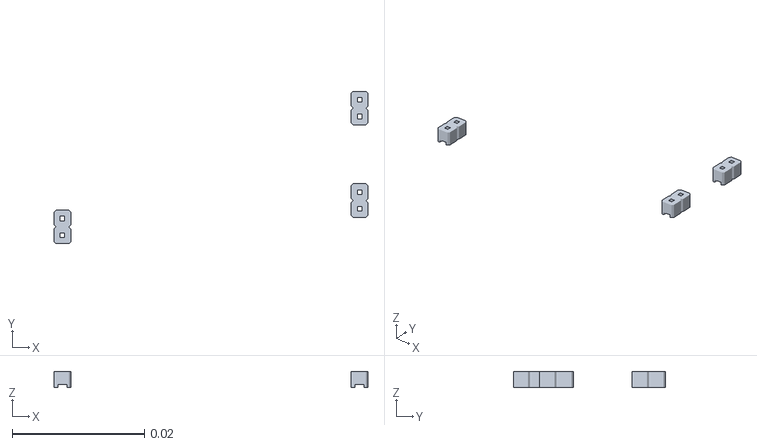
[picture p45: CAD file, 2026-11-12]
simulation/assets/pcb_material_10.obj
0.0475 x 0.0231 x 0.00247
