cnYui/switch-robot-diy/simulation/assets/pcb_material_14.obj

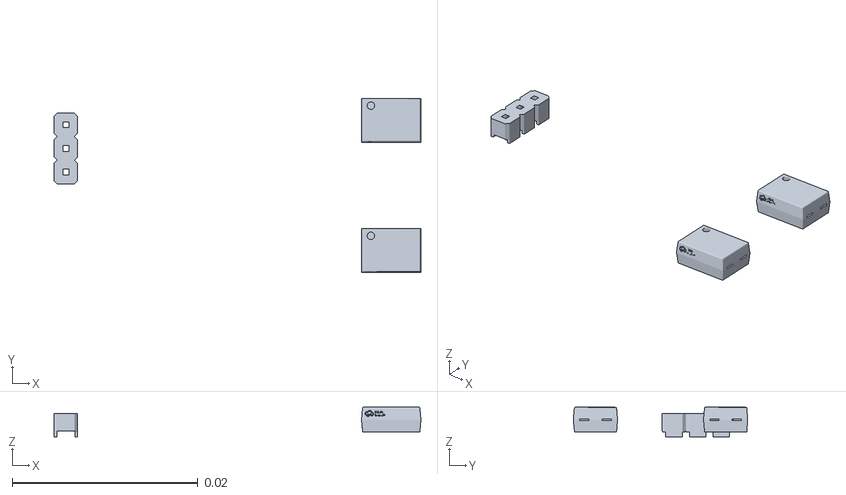
[picture p46: CAD file, 2026-11-12]
simulation/assets/pcb_material_14.obj
0.0395 x 0.0188 x 0.00318
