cnYui/switch-robot-diy/simulation/assets/pcb_material_01.obj

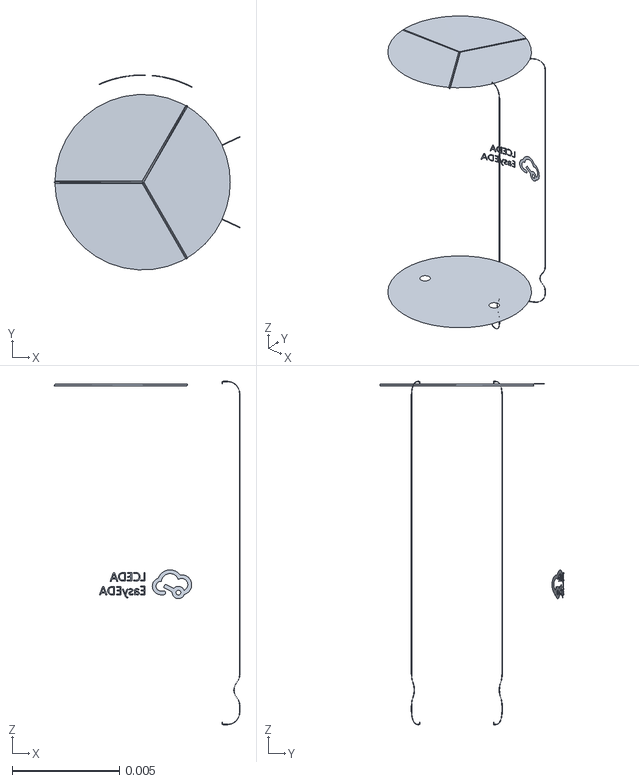
[picture p47: CAD file, 2026-11-12]
simulation/assets/pcb_material_01.obj
0.00868 x 0.00909 x 0.016
