cnYui/switch-robot-diy/simulation/assets/arm_v06_col_00.obj

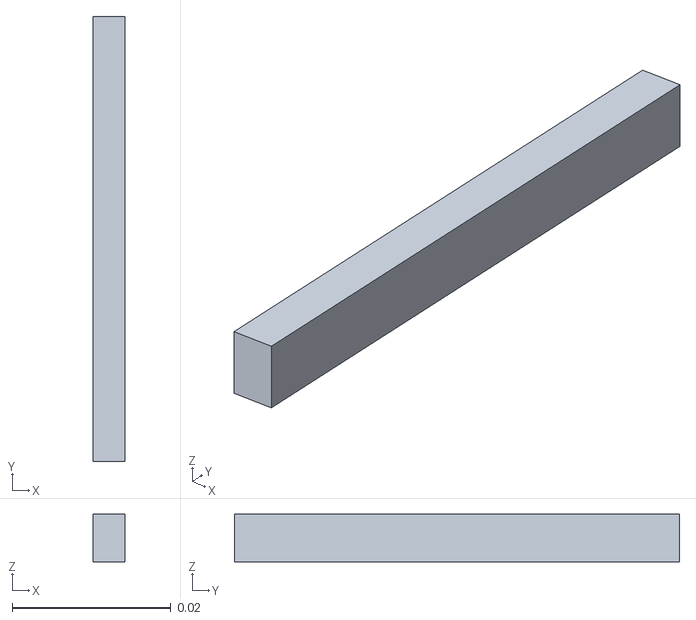
[picture p48: CAD file, 2026-11-12]
simulation/assets/arm_v06_col_00.obj
0.004 x 0.056 x 0.006
