cnYui/switch-robot-diy/simulation/assets/cradle.obj

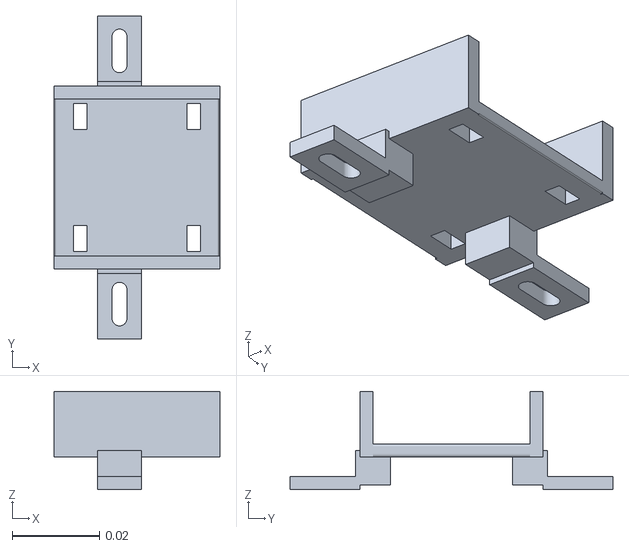
[picture p49: CAD file, 2026-11-12]
simulation/assets/cradle.obj
0.038 x 0.074 x 0.0225
