cnYui/switch-robot-diy/simulation/assets/pcb_material_21.obj

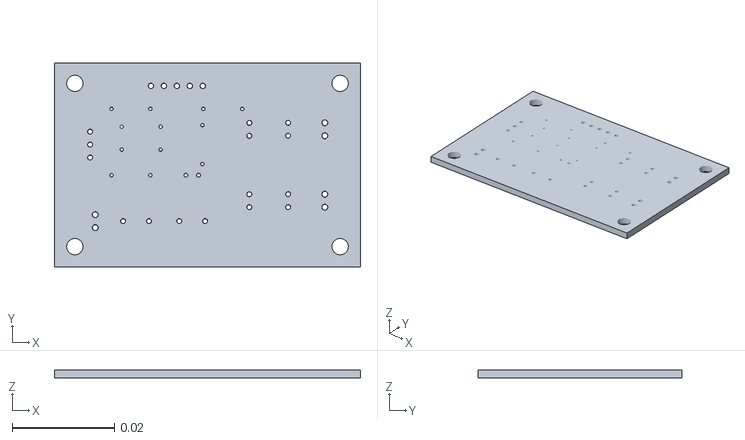
[picture p50: CAD file, 2026-11-12]
simulation/assets/pcb_material_21.obj
0.06 x 0.04 x 0.00165
