cnYui/switch-robot-diy/simulation/assets/pcb_material_04.obj

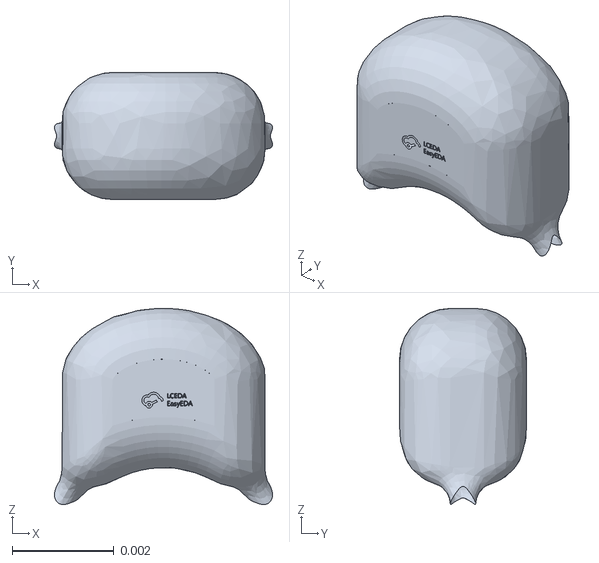
[picture p51: CAD file, 2026-11-12]
simulation/assets/pcb_material_04.obj
0.00429 x 0.0025 x 0.00386
