cnYui/switch-robot-diy/(list of files, cad)

Other CAD files:
mechanical/PRINT_03_double_press_arm.stl
simulation/assets/cradle_col_05.obj
simulation/assets/frame_col_00.obj
simulation/assets/frame_col_02.obj
simulation/assets/cradle_col_03.obj
simulation/assets/arm_v06_col_03.obj
simulation/assets/cradle_col_01.obj
simulation/assets/arm_v06_col_02.obj
demo/switch_robot_assembled_v02.blend
fit-check/enclosure_fit_v03.blend
mechanical/archive/PRINT_01_86_adjustable_frame_V01_slotted.stl
mechanical/archive/PRINT_03_double_press_arm_V01_DO_NOT_PRINT.stl
mechanical/archive/PRINT_04_gateway_case_V01_68x48_PCB_DOES_NOT_FIT.stl
mechanical/archive/PRINT_05_gateway_lid_V01_68x48.stl
mechanical/switch_robot_86_v01.blend
mechanical/switch_robot_86_v06.blend
mechanical/switch_robot_86_v07_fasteners.blend
simulation/assets/arm_v01.obj
simulation/assets/arm_v01_col_01.obj
simulation/assets/arm_v01_col_02.obj
simulation/assets/arm_v01_col_03.obj
simulation/assets/arm_v01_col_04.obj
simulation/assets/arm_v02.obj
simulation/assets/arm_v02_col_01.obj
simulation/assets/arm_v02_col_02.obj
simulation/assets/arm_v02_col_03.obj
simulation/assets/arm_v02_col_04.obj
simulation/assets/arm_v05.obj
simulation/assets/arm_v05_col_01.obj
simulation/assets/arm_v05_col_02.obj
simulation/assets/arm_v05_col_03.obj
simulation/assets/arm_v05_col_04.obj
