cnYui/switch-robot-diy/demo/assembled_annotated.png

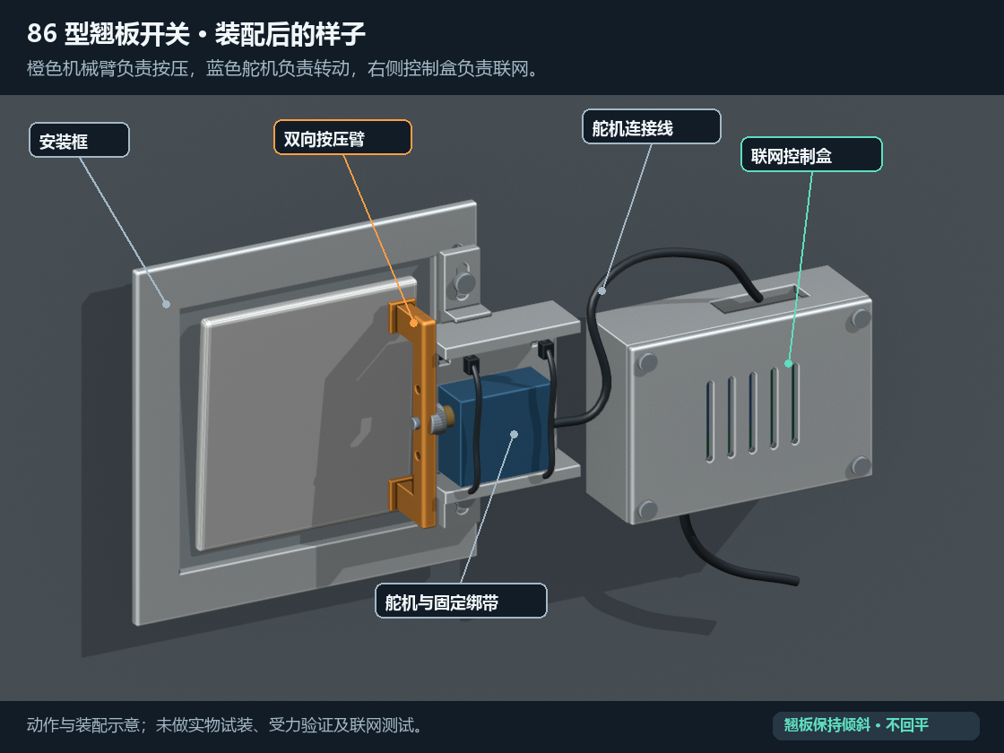
demo/assembled_annotated.png
