cnYui/switch-robot-diy/demo/assembled_raw.png

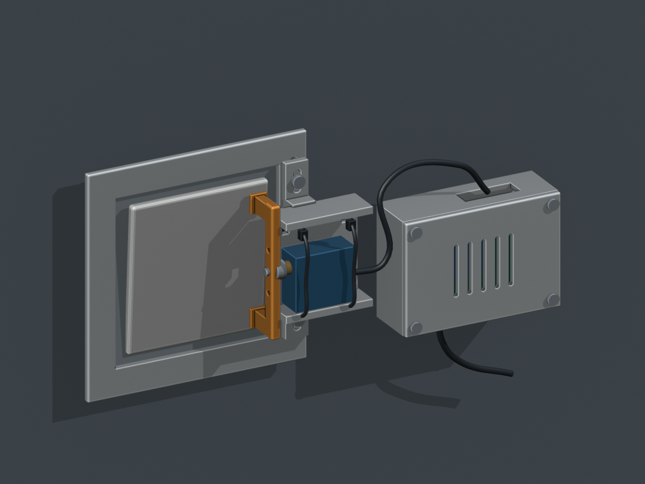
demo/assembled_raw.png
