cnYui/switch-robot-diy/demo/assembly_and_operation.gif

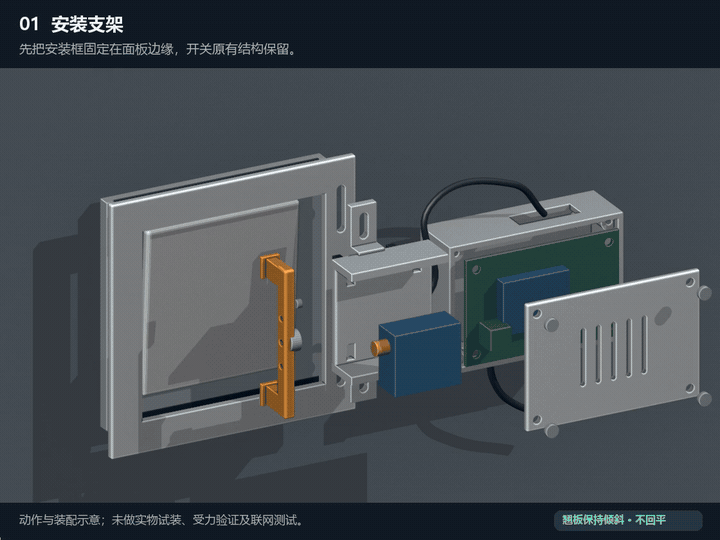
demo/assembly_and_operation.gif
