cnYui/switch-robot-diy/mechanical/assembly_preview.png

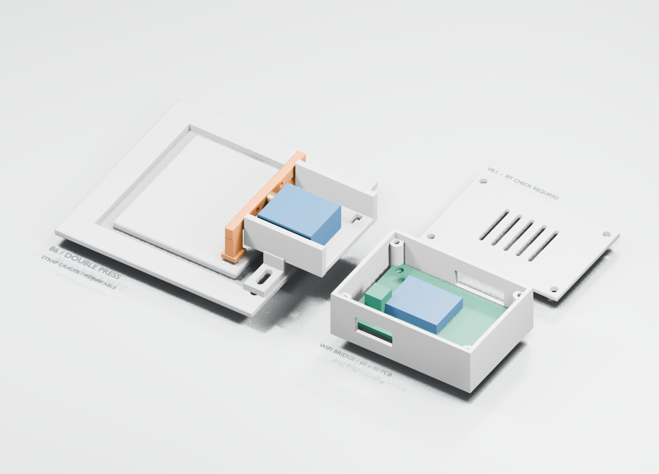
mechanical/assembly_preview.png
