cnYui/switch-robot-diy/simulation/results/index.html

# 开关机器人 · MuJoCo 接触测试

本次完成 205 个仿真场景：30 个具名功能/故障用例、63 组 V0.6 安装高度与行程扫描、63 组修复前刚性压垫的对照扫描、17 组力矩/阻力扫描、32 组组合参数扰动。仿真版本 MuJoCo 3.17.0。

参数未实测校准。测试覆盖机械运动、刚体碰撞与虚拟 PWM 控制链路。ESP32 真固件、电源电流、Wi-Fi/蓝牙、打印件强度、粘贴与螺丝可靠性尚未验证。6 N 是本次人为设定的测试限值，不是实测开关或打印件的承载极限。

视频回放 MuJoCo 求解轨迹，按 0.6 倍速度显示。侧视图用于观察翘板翻转与接触。

## 发现与修改

旧 STL 的中立位置与翘板有约 0.216 mm 穿入，原网格布尔交集约 2.677 mm³。动画版抬高按压头后，中立干涉消失，但约 5° 附近的垫座仍与支架有细小交集。刚体模型在此受阻；这种楔紧的巨大反力不能用于预测真实塑料强度。

V0.5 把垫座宽度从 7 mm 改为 5 mm，原始网格交集扫描中不再有同一干涉，但它仍是刚性压垫：按压命令角度的可用范围只有约 3.4°，安装高度偏低 1 mm 时中立空隙不足，臂退不回，断电后臂会停在按压位置。

V0.6 做了四处修改：① 以通过交集检查的 V0.5 几何为正式按压臂；② 指杆下端抬高到 17.5 mm，下面粘 4×7×5.5 mm 的弹性压垫（泡棉或 TPU；本仿真假设刚度 2 N/mm、有效行程 2.5 mm），过行程由压垫吸收；③ 支架整体垫高 1.0 mm（每个安装脚下叠两片 M3 平垫圈），中立空隙约 2.21 mm；④ 名义按压角改为 17°。同类扫描里，修复前即使选最好的固定按压角（11.4°），可通过的安装高度偏差范围也只有 -0.5 ~ +1.5 mm；V0.6 在名义 17° 下为 -1.5 ~ +1.5 mm。

V0.6 完成 20 次连续开关，模型按压峰值约 3.70 N。32 组扰动（含 ±1 mm 安装高度、±1.5° 按压角、±20% 压垫刚度）有 32 组通过；这些人为分布不能转换成实物可靠性概率。代价是：压垫最大弹簧力约 5 N，翻转阻力峰值达到 4.5 N 以上的开关会把压垫压到底（见 v06_switch_beyond_pad_capacity）。没有回位弹簧时，断电后压垫只能把臂推到刚脱离接触的位置；加 0.05 N·m/rad 的回位弹簧后臂回中，但该弹簧尚未进入 CAD，真实舵机的反向转动阻力也没有测量。

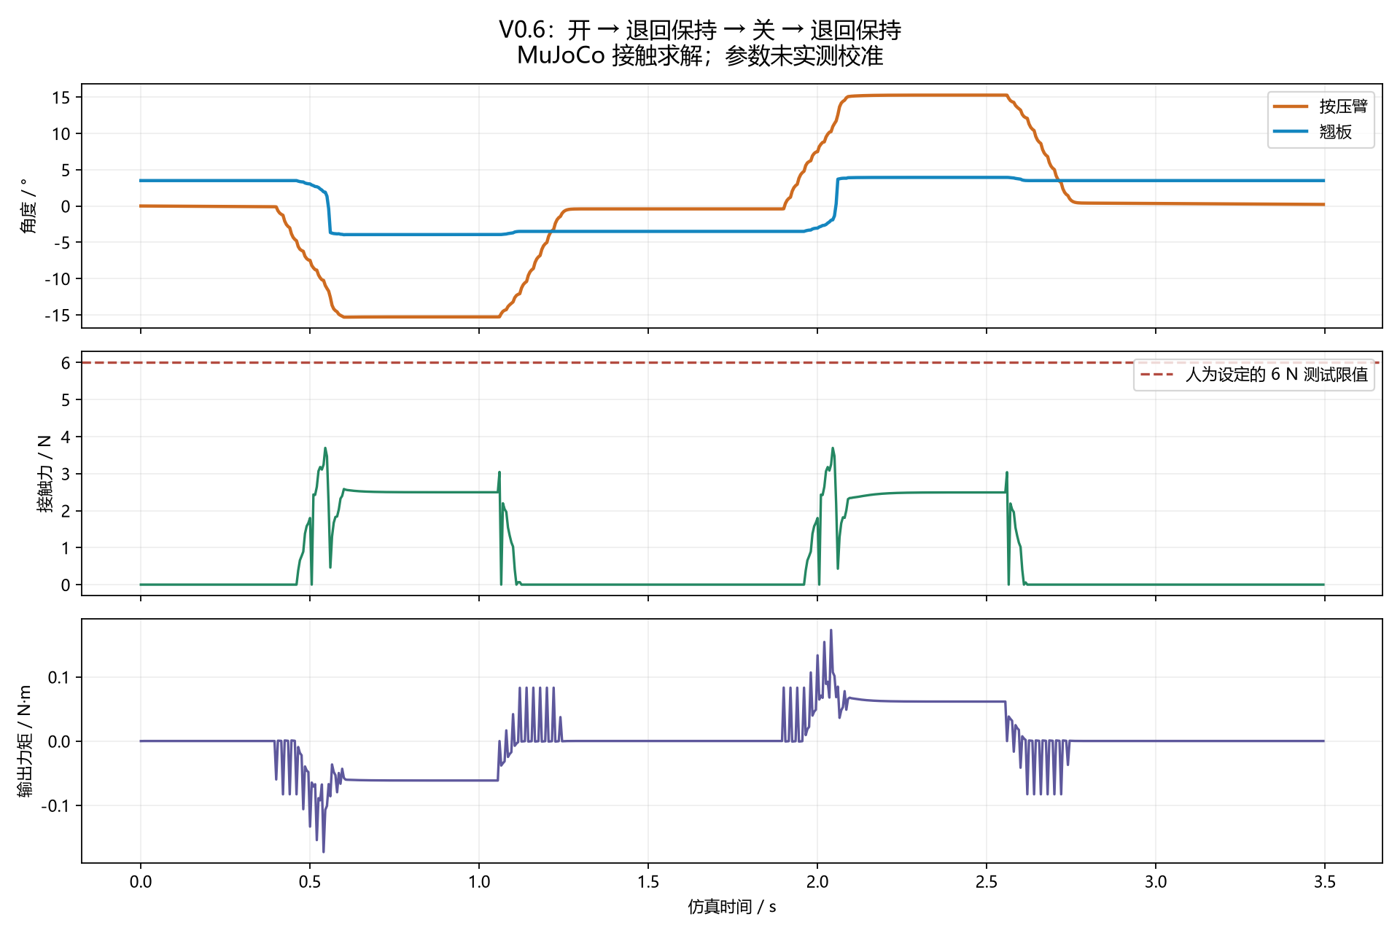
[picture p56: simulation/results/nominal_curves.png]
实际求解曲线


## 安装与行程边界

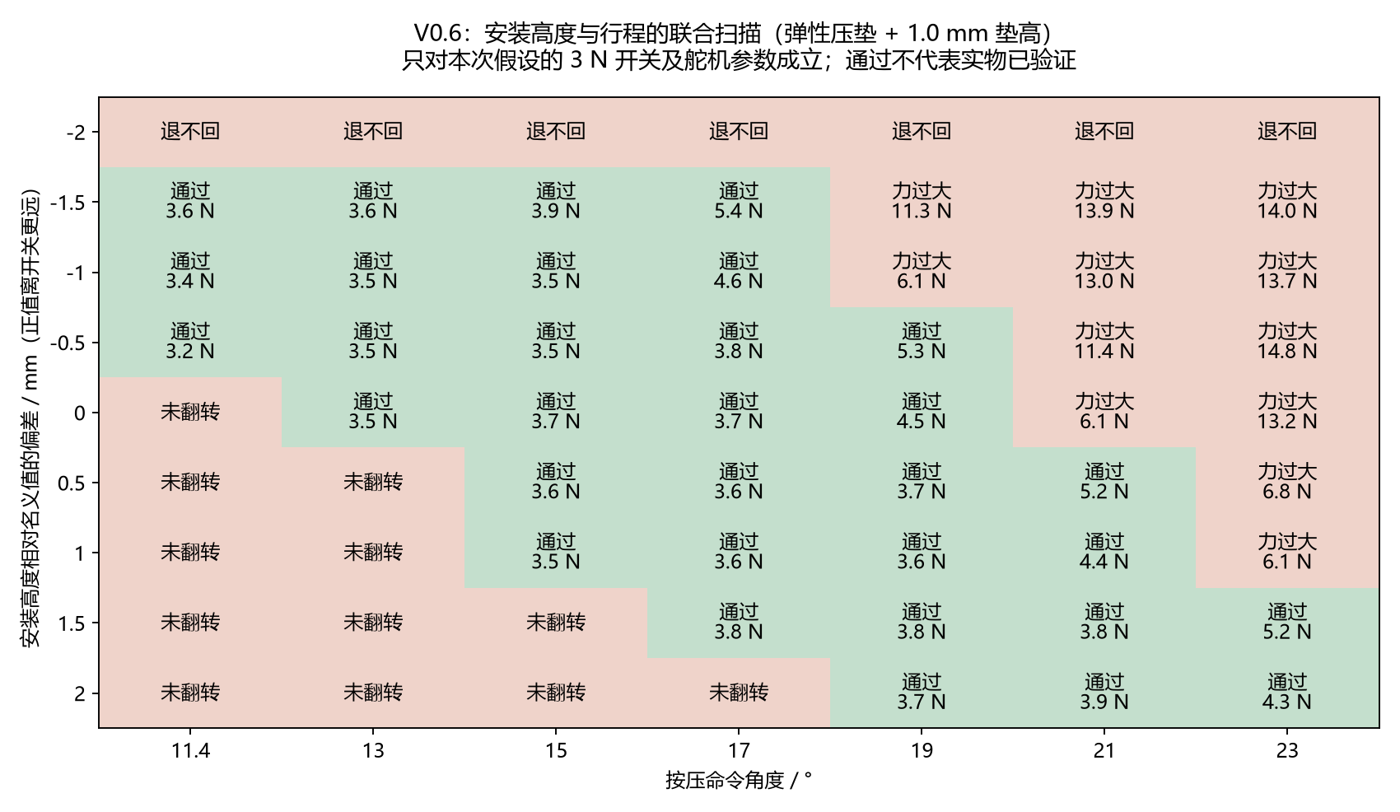
[picture p57: simulation/results/height_stroke_map.png]
V0.6 安装高度与行程参数扫描


图中的数值仅适用于所设定的舵机、质量、摩擦、压垫刚度和 3 N 翻转阻力。实际安装后需要测量高度并校准行程。

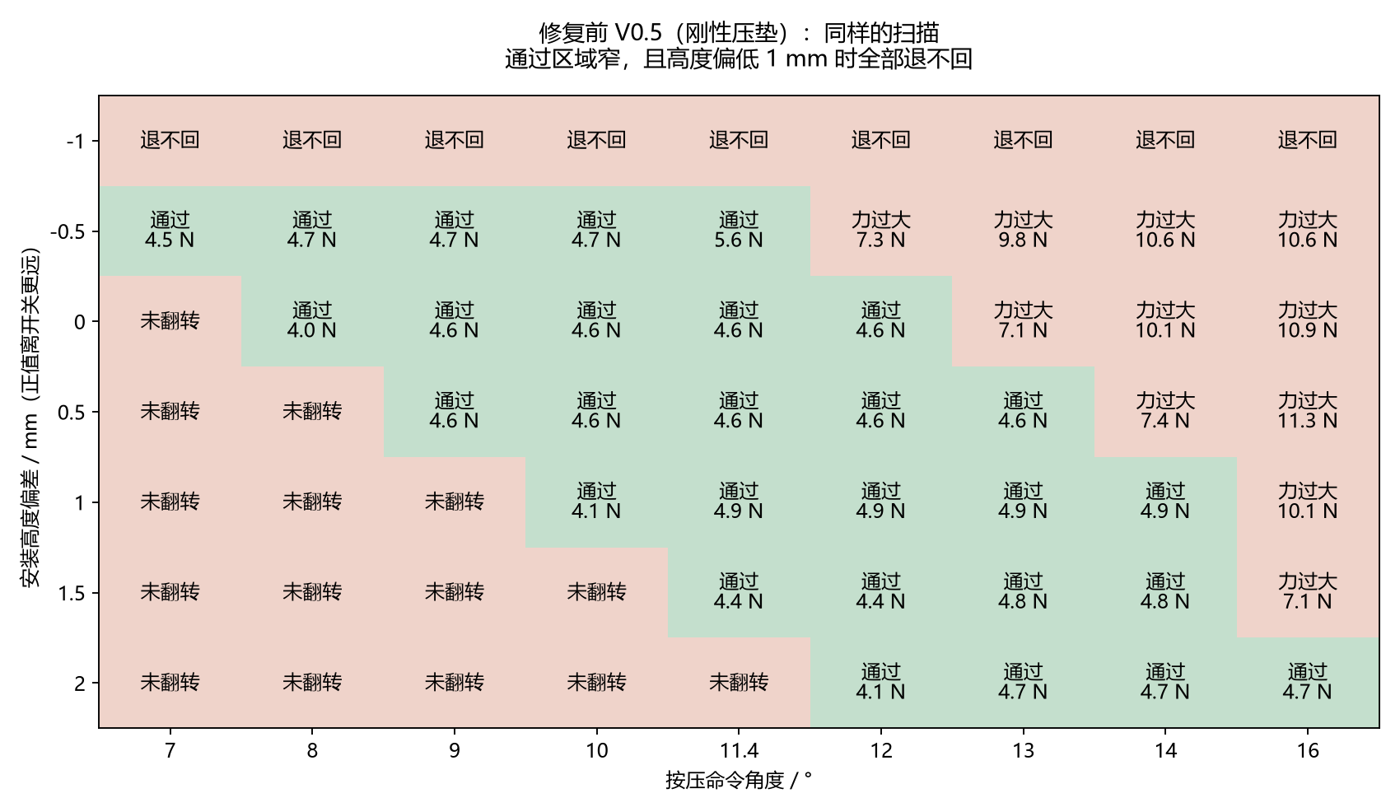
[picture p58: simulation/results/legacy_v05_height_stroke_map.png]
修复前的同类扫描


## 检查逐时刻记录

用例

## 功能及故障用例

用例 | 用途 | 观察结果 | 翻转次数 | 峰值力/N | 两稳态空隙/mm
v01_existing_stl | 预期故障 | INITIAL_PRELOAD, ARM_NOT_RETRACTED, CONTACT_WHILE_IDLE, EXCEEDS_ASSUMED_6N_TEST_LIMIT | 2 | 10.37 | -0.42
v02_animation_geometry | 预期故障 | FRAME_OR_CRADLE_COLLISION | 0 | 4.70 | 1.12
v05_rigid_baseline | 正常功能 | 通过 | 2 | 4.64 | 1.12
v05_rigid_power_loss | 预期故障 | NO_RETRACTION_WITHOUT_POWER | 1 | 4.64 | -2.58
v06_nominal | 正常功能 | 通过 | 2 | 3.70 | 2.21
v06_on_then_hold | 正常功能 | 通过 | 1 | 3.70 | 2.12
v06_off_then_hold | 正常功能 | 通过 | 1 | 3.70 | 2.29
v06_repeated_command | 正常功能 | 通过 | 2 | 3.70 | 2.20
v06_fast_reversal | 正常功能 | 通过 | 2 | 3.70 | 2.19
v06_stop_mid_press | 正常功能 | 通过 | 0 | 3.07 | 2.12
v06_pwm_dropout | 正常功能 | 通过 | 1 | 3.70 | 2.12
v06_power_loss | 预期故障 | NO_RETRACTION_WITHOUT_POWER | 1 | 3.70 | 1.85
v06_power_loss_with_return_spring | 正常功能 | 通过 | 1 | 3.67 | 2.24
v06_weak_servo | 预期故障 | TARGET_NOT_REACHED | 0 | 1.21 | 2.12
v06_stiff_switch | 预期故障 | TARGET_NOT_REACHED, EXCEEDS_ASSUMED_6N_TEST_LIMIT, PAD_BOTTOMED_OUT | 0 | 11.74 | 2.12
v06_harder_switch_4N | 正常功能 | 通过 | 1 | 4.77 | 2.12
v06_switch_beyond_pad_capacity | 预期故障 | PAD_BOTTOMED_OUT | 1 | 5.97 | 2.12
v06_insufficient_stroke | 预期故障 | TARGET_NOT_REACHED | 0 | 0.36 | 2.12
v06_excessive_stroke | 预期故障 | EXCEEDS_ASSUMED_6N_TEST_LIMIT, PAD_BOTTOMED_OUT | 1 | 6.78 | 2.12
v06_large_mount_offset | 预期故障 | FRAME_OR_CRADLE_COLLISION, TARGET_NOT_REACHED | 0 | 0.00 | 7.66
v06_large_height_offset | 预期故障 | TARGET_NOT_REACHED | 0 | 1.32 | 6.12
v06_narrow_rocker_missed | 预期故障 | TARGET_NOT_REACHED | 0 | 0.00 | 12.36
v06_three_gang_right | 正常功能 | 通过 | 2 | 3.70 | 2.21
v06_twenty_cycles | 正常功能 | 通过 | 20 | 3.70 | 2.21
v06_dt_0p00025 | 正常功能 | 通过 | 2 | 3.75 | 2.21
v06_dt_6p25e-05 | 正常功能 | 通过 | 2 | 3.63 | 2.21
v06_friction_0p05 | 正常功能 | 通过 | 2 | 3.21 | 2.21
v06_friction_0p9 | 正常功能 | 通过 | 2 | 4.32 | 2.21
v06_no_contact_negative_control | 预期故障 | TARGET_NOT_REACHED | 0 | 0.00 | 2.12
v06_soft_contact_sensitivity | 正常功能 | 通过 | 2 | 3.73 | 2.21

## PCB 与壳体

已把正式 PCB、元件库模型和 V0.3 壳体放入同一场景。未剪元件引脚有顶到盒底的顶点；按板底以下保留 1.5 mm 引脚的假设修剪后，顶点包含检查未发现板件进入壳体或盒盖。此检查不是完整三角面相交或制造公差证明。元件库高度有近似，外接主控、插头和线材弯曲空间仍需核对。

## 文件与实时操作

V0.6 按压臂 STL · 用例 CSV · 参数扫描 CSV · 验证证据 · 完整结果 JSON · 壳体检查记录

在 simulation 目录双击“打开实时仿真.cmd”。键 1 开、0 关、S 退回、P 切换自动循环；鼠标可旋转缩放模型。实时窗口调用完整的 Python 驱动与双稳态阻力模型。单独打开 XML 只会载入几何、关节和执行器定义。

本机 JSON/PWM 接口的进程与套接字已实际联调，测试包括非法输入、ON/OFF 请求、PWM 输入及超时回中。该接口当前仅驱动仿真；真实舵机是否超时回中，取决于之后实现的真板固件与舵机本身。

MuJoCo 官方建模文档 (https://mujoco.readthedocs.io/en/stable/modeling.html) · TowerPro SG90 参考规格 (https://towerpro.com.tw/product/sg90-7/) · M5Stack 同名舵机的不同规格 (https://docs.m5stack.com/en/accessory/SG90_Servo)
