cnYui/switch-robot-diy/simulation/results/parameter_sweep.csv

height_offset_mm | press_angle_deg | pass | peak_force_N | defects
-2 | 11.4 | False | 3.448307960742045 | ARM_NOT_RETRACTED
-2 | 13 | False | 3.448307960742045 | ARM_NOT_RETRACTED
-2 | 15 | False | 4.66256027243241 | ARM_NOT_RETRACTED
-2 | 17 | False | 6.1075333544595125 | ARM_NOT_RETRACTED|EXCEEDS_ASSUMED_6N_TEST_LIMIT|PAD_BOTTOMED_OUT
-2 | 19 | False | 12.864746032980324 | ARM_NOT_RETRACTED|EXCEEDS_ASSUMED_6N_TEST_LIMIT|PAD_BOTTOMED_OUT
-2 | 21 | False | 13.25923614844448 | ARM_NOT_RETRACTED|EXCEEDS_ASSUMED_6N_TEST_LIMIT|PAD_BOTTOMED_OUT
-2 | 23 | False | 13.433744046062287 | ARM_NOT_RETRACTED|EXCEEDS_ASSUMED_6N_TEST_LIMIT|PAD_BOTTOMED_OUT
-1.5 | 11.4 | True | 3.62191660375148
-1.5 | 13 | True | 3.62191660375148
-1.5 | 15 | True | 3.9251688711430663
-1.5 | 17 | True | 5.373297007455749
-1.5 | 19 | False | 11.307419399794494 | EXCEEDS_ASSUMED_6N_TEST_LIMIT|PAD_BOTTOMED_OUT
-1.5 | 21 | False | 13.924606633574946 | EXCEEDS_ASSUMED_6N_TEST_LIMIT|PAD_BOTTOMED_OUT
-1.5 | 23 | False | 13.955909750766104 | EXCEEDS_ASSUMED_6N_TEST_LIMIT|PAD_BOTTOMED_OUT
-1 | 11.4 | True | 3.3618970729191453
-1 | 13 | True | 3.5494262396187435
-1 | 15 | True | 3.5494262396187435
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
