cnYui/switch-robot-diy/simulation_results_v05_archive/index.html

# 开关机器人 · MuJoCo 接触测试

本次完成 116 个仿真场景：25 个具名功能/故障用例、42 组安装高度与行程扫描、17 组力矩/阻力扫描、32 组组合参数扰动。仿真版本 MuJoCo 3.17.0。

参数未实测校准。测试覆盖机械运动、刚体碰撞与虚拟 PWM 控制链路。ESP32 真固件、电源电流、Wi-Fi/蓝牙、打印件强度、粘贴与螺丝可靠性尚未验证。6 N 是本次人为设定的测试限值，不是实测开关或打印件的承载极限。

视频回放 MuJoCo 求解轨迹，按 0.6 倍速度显示。侧视图用于观察翘板翻转与接触。

## 发现与修改

旧 STL 的中立位置与翘板有约 0.216 mm 穿入，原网格布尔交集约 2.677 mm³。动画版抬高按压头后，中立干涉消失，但约 5° 附近的垫座仍与支架有细小交集。刚体模型在此受阻；这种楔紧的巨大反力不能用于预测真实塑料强度。

V0.5 候选件保留抬高后的高度，将垫座宽度从 7 mm 改为 5 mm。原始网格交集扫描中未再发现同一干涉。候选件完成 20 次连续开关，模型按压峰值约 4.64 N，最终回中后对翘板两稳态的最小空隙约 1.12 mm。32 组选定扰动参数有 32/32 组通过；这些人为分布不能转换成实物可靠性概率。

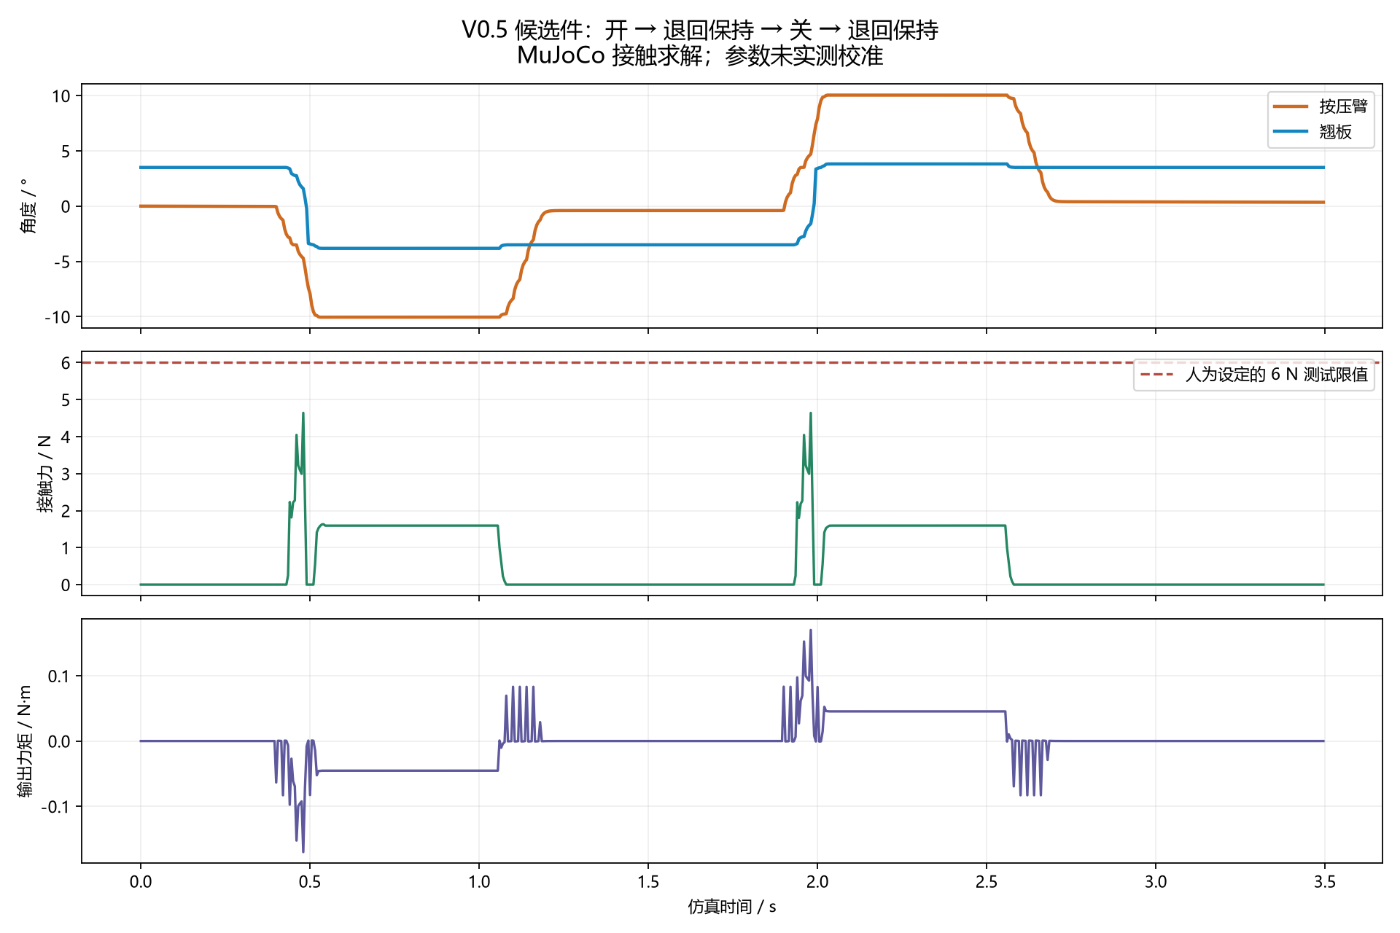
[picture p59: simulation_results_v05_archive/nominal_curves.png]
实际求解曲线


## 安装与行程边界

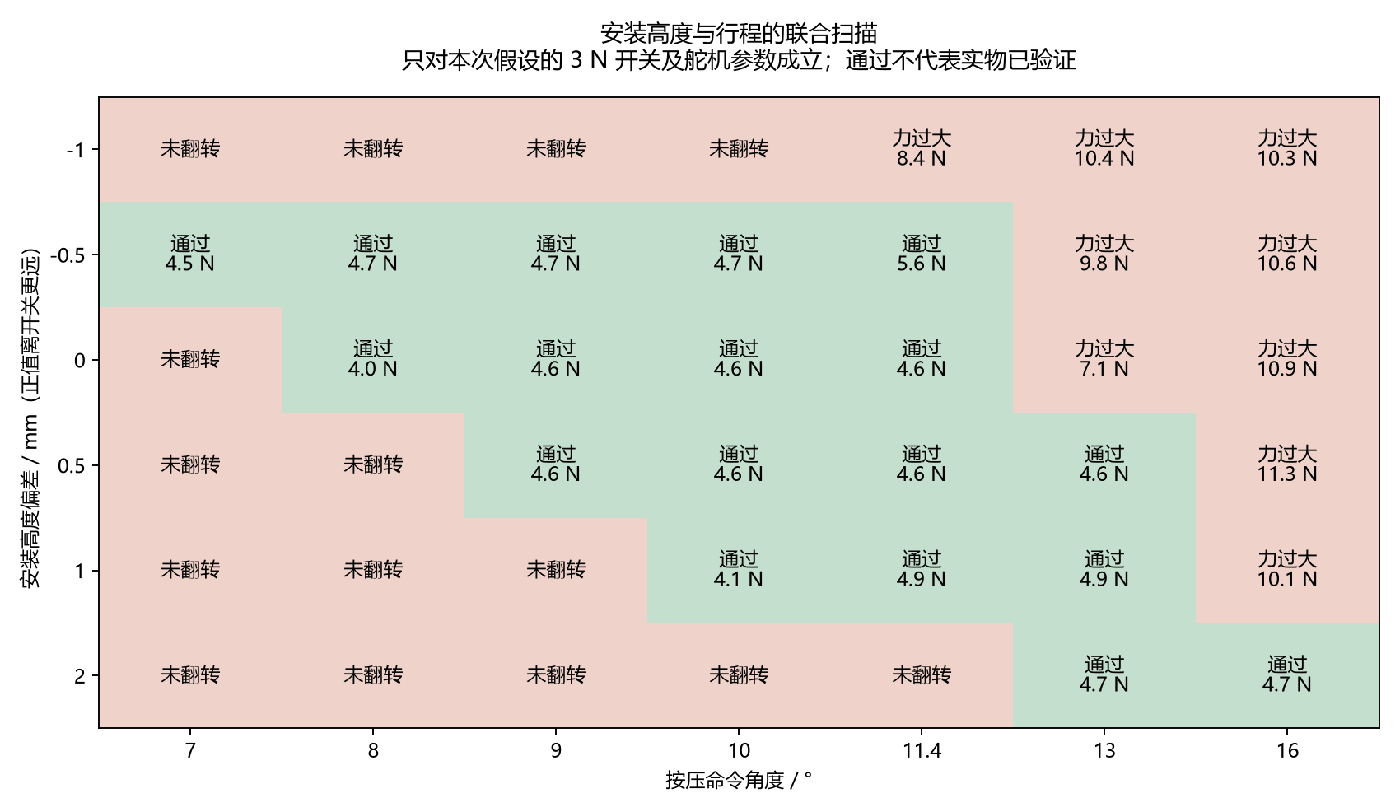
[picture p60: simulation_results_v05_archive/height_stroke_map.png]
安装高度与行程参数扫描


图中的数值仅适用于所设定的舵机、质量、摩擦和 3 N 翻转阻力。实际安装后需要测量高度并校准行程。

## 检查逐时刻记录

用例

## 功能及故障用例

用例 | 用途 | 观察结果 | 翻转次数 | 峰值力/N | 两稳态空隙/mm
v01_existing_stl | 预期故障 | INITIAL_PRELOAD, ARM_NOT_RETRACTED, CONTACT_WHILE_IDLE, EXCEEDS_ASSUMED_6N_TEST_LIMIT | 2 | 10.37 | -0.42
v02_animation_geometry | 预期故障 | FRAME_OR_CRADLE_COLLISION | 0 | 4.70 | 1.12
v05_nominal | 正常功能 | 通过 | 2 | 4.64 | 1.12
v05_on_then_hold | 正常功能 | 通过 | 1 | 4.64 | 1.09
v05_off_then_hold | 正常功能 | 通过 | 1 | 4.64 | 1.15
v05_repeated_command | 正常功能 | 通过 | 2 | 4.64 | 1.11
v05_fast_reversal | 正常功能 | 通过 | 2 | 4.64 | 1.11
v05_stop_mid_press | 正常功能 | 通过 | 1 | 4.64 | 1.09
v05_pwm_dropout | 正常功能 | 通过 | 1 | 4.64 | 1.09
v05_power_loss | 预期故障 | NO_RETRACTION_WITHOUT_POWER | 1 | 4.64 | -2.58
v05_weak_servo | 预期故障 | TARGET_NOT_REACHED | 0 | 0.97 | 1.09
v05_stiff_switch | 预期故障 | TARGET_NOT_REACHED, EXCEEDS_ASSUMED_6N_TEST_LIMIT | 0 | 6.54 | 1.09
v05_insufficient_stroke | 预期故障 | TARGET_NOT_REACHED | 0 | 3.01 | 1.09
v05_excessive_stroke | 预期故障 | EXCEEDS_ASSUMED_6N_TEST_LIMIT | 1 | 11.01 | 1.09
v05_large_mount_offset | 预期故障 | FRAME_OR_CRADLE_COLLISION, TARGET_NOT_REACHED | 0 | 0.00 | 6.87
v05_large_height_offset | 预期故障 | TARGET_NOT_REACHED | 0 | 1.69 | 4.09
v05_narrow_rocker_missed | 预期故障 | TARGET_NOT_REACHED | 0 | 0.00 | 11.68
v05_three_gang_right | 正常功能 | 通过 | 2 | 4.64 | 1.12
v05_twenty_cycles | 正常功能 | 通过 | 20 | 4.64 | 1.12
v05_dt_0p00025 | 正常功能 | 通过 | 2 | 5.06 | 1.12
v05_dt_6p25e-05 | 正常功能 | 通过 | 2 | 4.69 | 1.12
v05_friction_0p05 | 正常功能 | 通过 | 2 | 3.90 | 1.12
v05_friction_0p9 | 正常功能 | 通过 | 2 | 5.32 | 1.12
v05_no_contact_negative_control | 预期故障 | TARGET_NOT_REACHED | 0 | 0.00 | 1.09
v05_soft_contact_sensitivity | 正常功能 | 通过 | 2 | 4.80 | 1.12

## PCB 与壳体

已把正式 PCB、元件库模型和 V0.3 壳体放入同一场景。未剪元件引脚有顶到盒底的顶点；按板底以下保留 1.5 mm 引脚的假设修剪后，顶点包含检查未发现板件进入壳体或盒盖。此检查不是完整三角面相交或制造公差证明。元件库高度有近似，外接主控、插头和线材弯曲空间仍需核对。

## 文件与实时操作

候选按压臂 STL · 用例 CSV · 参数扫描 CSV · 验证证据 · 完整结果 JSON · 壳体检查记录

在 simulation 目录双击“打开实时仿真.cmd”。键 1 开、0 关、S 退回、P 切换自动循环；鼠标可旋转缩放模型。实时窗口调用完整的 Python 驱动与双稳态阻力模型。单独打开 XML 只会载入几何、关节和执行器定义。

本机 JSON/PWM 接口的进程与套接字已实际联调，测试包括非法输入、ON/OFF 请求、PWM 输入及超时回中。该接口当前仅驱动仿真；真实舵机是否超时回中，取决于之后实现的真板固件与舵机本身。

MuJoCo 官方建模文档 (https://mujoco.readthedocs.io/en/stable/modeling.html) · TowerPro SG90 参考规格 (https://towerpro.com.tw/product/sg90-7/) · M5Stack 同名舵机的不同规格 (https://docs.m5stack.com/en/accessory/SG90_Servo)
