cnYui/switch-robot-diy/simulation_results_v05_archive/case_summary.csv

case | expected_failure | observed_defects | target_reached | flips | peak_force_N | rest_clearance_mm | warnings
v01_existing_stl | INITIAL_PRELOAD | INITIAL_PRELOAD|ARM_NOT_RETRACTED|CONTACT_WHILE_IDLE|EXCEEDS_ASSUMED_6N_TEST_LIMIT | True | 2 | 10.371697439177137 | -0.42285513574361305 | 0
v02_animation_geometry | FRAME_OR_CRADLE_COLLISION | FRAME_OR_CRADLE_COLLISION | True | 0 | 4.697588271798531 | 1.1196814776041015 | 0
v05_nominal |  |  | True | 2 | 4.640468898659892 | 1.116381297516193 | 0
v05_on_then_hold |  |  | True | 1 | 4.640468898659892 | 1.091760436591446 | 0
v05_off_then_hold |  |  | True | 1 | 4.63989022688544 | 1.1485764496045328 | 0
v05_repeated_command |  |  | True | 2 | 4.640468898659892 | 1.1131629486486645 | 0
v05_fast_reversal |  |  | True | 2 | 4.640468898659892 | 1.109944812205569 | 0
v05_stop_mid_press |  |  | True | 1 | 4.640468898659892 | 1.091760436591446 | 0
v05_pwm_dropout |  |  | True | 1 | 4.640468898659892 | 1.091760436591446 | 0
v05_power_loss | NO_RETRACTION_WITHOUT_POWER | NO_RETRACTION_WITHOUT_POWER | True | 1 | 4.640468898659892 | -2.582632098222262 | 0
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
