cnYui/switch-robot-diy/simulation_results_v05_archive/parameter_sweep.csv

height_offset_mm | press_angle_deg | pass | peak_force_N | defects
-1 | 7 | False | 4.262305060999144 | ARM_NOT_RETRACTED
-1 | 8 | False | 4.411041102058157 | ARM_NOT_RETRACTED
-1 | 9 | False | 4.411041102058157 | ARM_NOT_RETRACTED
-1 | 10 | False | 4.486073094805931 | ARM_NOT_RETRACTED
-1 | 11.4 | False | 8.350649804857797 | ARM_NOT_RETRACTED|EXCEEDS_ASSUMED_6N_TEST_LIMIT
-1 | 13 | False | 10.35187023157448 | ARM_NOT_RETRACTED|EXCEEDS_ASSUMED_6N_TEST_LIMIT
-1 | 16 | False | 10.348577472749334 | ARM_NOT_RETRACTED|EXCEEDS_ASSUMED_6N_TEST_LIMIT
-0.5 | 7 | True | 4.548805499378252
-0.5 | 8 | True | 4.726260176515477
-0.5 | 9 | True | 4.726260176515477
-0.5 | 10 | True | 4.726260176515477
-0.5 | 11.4 | True | 5.629679618253666
-0.5 | 13 | False | 9.798260540979463 | EXCEEDS_ASSUMED_6N_TEST_LIMIT
-0.5 | 16 | False | 10.632313796463468 | EXCEEDS_ASSUMED_6N_TEST_LIMIT
0 | 7 | False | 3.8672408035706085 | TARGET_NOT_REACHED
0 | 8 | True | 4.045180742653739
0 | 9 | True | 4.640468855030836
0 | 10 | True | 4.640468855030836
0 | 11.4 | True | 4.640468855030836
0 | 13 | False | 7.127837481556673 | EXCEEDS_ASSUMED_6N_TEST_LIMIT
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
