cnYui/switch-robot-diy/simulation/results/v06_nominal_press.png

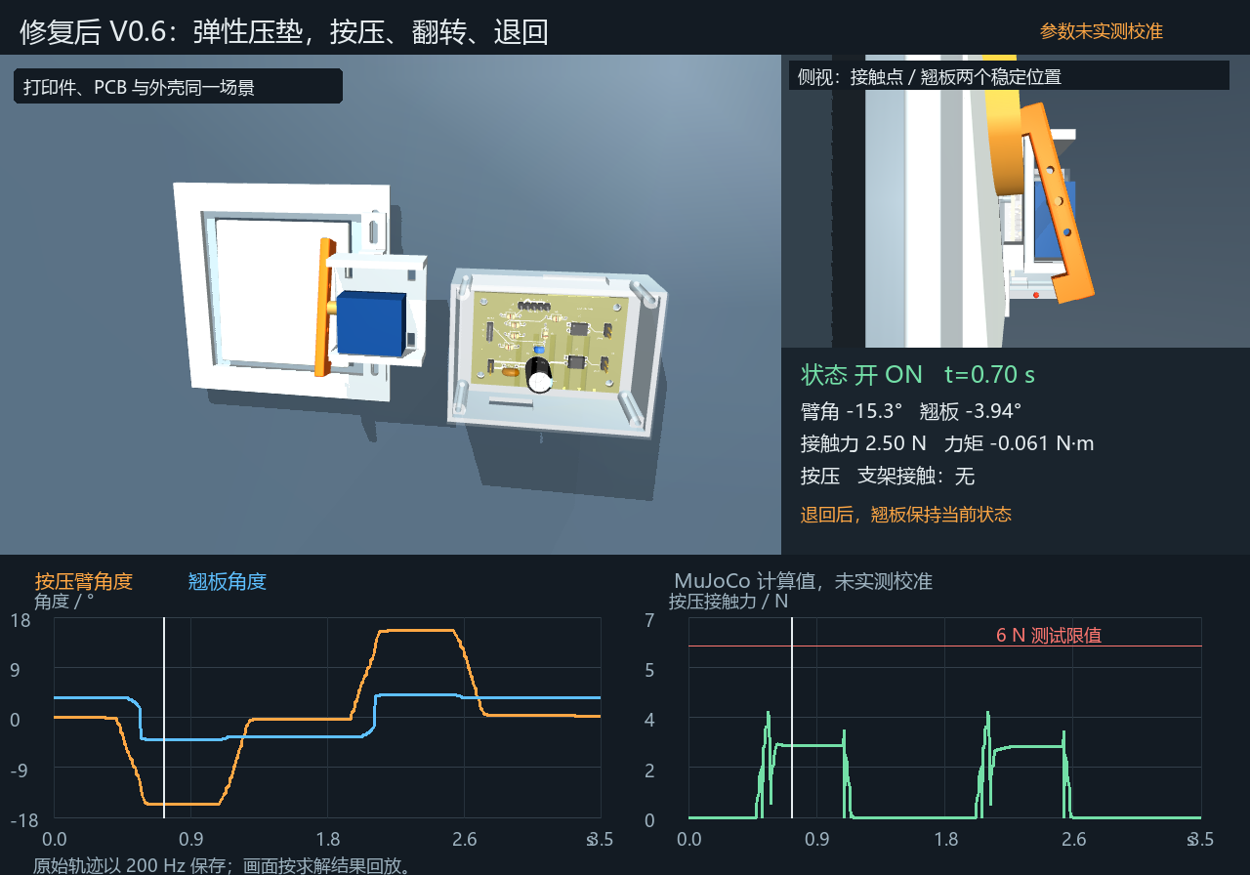
simulation/results/v06_nominal_press.png
