cnYui/switch-robot-diy/simulation/results/view_previews.jpg

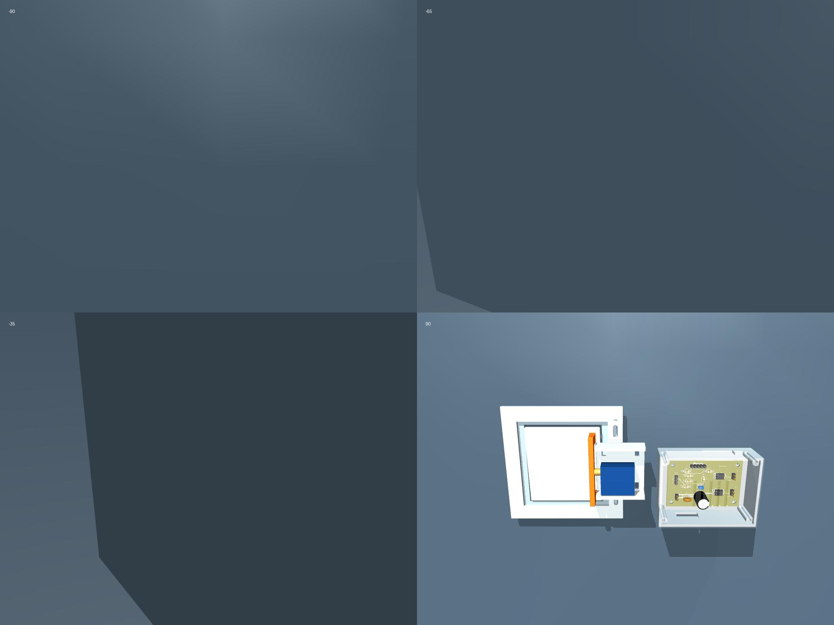
simulation/results/view_previews.jpg
