cnYui/switch-robot-diy/(list of files, drawings)

Other design files:
electronics/v04/carrier_v04.dsn
electronics/v04/carrier_v04_routing.dsn
electronics/v04/pcb_drc_final.json
electronics/v04/pcb_final_state.json
electronics/v04/pcb_imported_components.json
electronics/v04/pcb_layout_mm.json
electronics/v04/pcb_mechanical_primitives.json
electronics/v04/pcb_placed.json
electronics/v04/pcb_routed_state.json
electronics/v04/pcb_rules_before.json
electronics/v04/pcb_rules_configured.json
electronics/v04/pcb_rules_readback.json
electronics/v04/pcb_stack_and_refs.json
electronics/v04/sch_current_state.json
electronics/v04/schematic_binding.json
electronics/v04/schematic_erc.json
electronics/v04/schematic_erc_final.json
electronics/v04/schematic_layout_result.json
simulation/assets/pcb_materials.json
simulation/results/pcb_case_check.json
simulation_results_v05_archive/pcb_case_check.json
