cnYui/switch-robot-diy/(commit log)

2026-11-12 Add 86 switch-robot DIY project: Blender parts, EasyEDA PCB, MuJoCo simulation
    Mechanical (Blender/STL), carrier PCB (EasyEDA Pro, V0.4), fit checks, demo
    video, and a MuJoCo digital prototype with the V0.6 mechanical fixes
    (elastic pads, 1.0 mm shim stack, 17 degree press angle, frame pilot holes)
    and a hardware purchase list. Simulation-verified only; no physical tests.
    [PRINT_01_86_adjustable_frame.stl, PRINT_01_86_adjustable_frame_V01_slotted.stl, PRINT_02_strap_servo_cradle.stl, PRINT_03_double_press_arm.stl, PRINT_03_double_press_arm_V01_DO_NOT_PRINT.stl, PRINT_04_gateway_case.stl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]
2026-11-12 Fill Taobao product picks into hardware BOM
2026-11-12 Model every fastener in CAD and check fit (V0.7)
    Add screw and washer solids to a new V0.7 assembly blend, verify
    interference and thread engagement by point sampling, swap in the V0.3
    gateway case (old case could not hold the PCB), and update the BOM.
    [PRINT_04_gateway_case.stl, PRINT_04_gateway_case_V01_68x48_PCB_DOES_NOT_FIT.stl, PRINT_05_gateway_lid.stl, PRINT_05_gateway_lid_V01_68x48.stl, switch_robot_86_v07_fasteners.blend]
2026-11-12 Add Matter firmware for the switch robot (esp-matter, Wi-Fi)
    Exposes the robot as a Matter On/Off plug-in unit. Servo mode presses the
    ON/OFF side of the 86 rocker; PhotoMOS mode pulses the J4/J5 remote buttons.
    Not built or tested on hardware yet.
    Claude-Session: https://claude.ai/code/session_01LYYassgdsCV7LxXgGvCfuq
    [partitions.csv]
